Sasha7b9Work/S8-57M/readme.txt

Версия с дисплеем на stm32f479 и без мультиметра
