Sasha7b9Work/S8-57M/sources/Panel/src/Hardware/Keyboard.cpp

// (c) Aleksandr Shevchenko e-mail : Sasha7b9@tut.by
#include "defines.h"
#include "common/Command.h"
#include "Hardware/Keyboard.h"
#include "Hardware/HAL/HAL.h"
#include "Display/Text/Text.h"
#include "Hardware/Timer.h"
#include "Log.h"


#define SL0 GPIO_PIN_2
#define SL1 GPIO_PIN_13
#define SL2 GPIO_PIN_14
#define SL3 GPIO_PIN_15
#define SL4 GPIO_PIN_1
#define SL5 GPIO_PIN_2
#define SL6 GPIO_PIN_3
#define SL7 GPIO_PIN_0

#define RL0 GPIO_PIN_6
#define RL1 GPIO_PIN_5
#define RL2 GPIO_PIN_2
#define RL3 GPIO_PIN_12
#define RL4 GPIO_PIN_11
#define RL5 GPIO_PIN_10


static const Control controls[Keyboard::NUM_RL][Keyboard::NUM_SL] =
{ //          SL0/SL6                SL1/SL7                  SL2                     SL3                     SL4                     SL5              
    {Control::K_None,       Control::B_3,            Control::B_Down,        Control::K_None,        Control::B_TrigLevLess, Control::B_TrigLevMore,
     Control::B_RangeLessB, Control::B_RShiftMoreB},                                                                                            // RL0

    {Control::B_1,          Control::B_4,            Control::B_Right,       Control::B_Enter,       Control::K_Start,       Control::K_Trig,
     Control::B_RangeMoreB, Control::B_RShiftLessB},                                                                                            // RL1

    {Control::B_2,          Control::B_5,            Control::B_Up,          Control::B_Left,        Control::K_None,        Control::K_None,
     Control::K_None,       Control::K_ChannelB},                                                                                               // RL2

    {Control::K_Function,   Control::K_Service,      Control::B_RangeLessA,  Control::K_RangeMoreA,  Control::K_None,        Control::B_TShiftLess,
     Control::K_None,       Control::K_None},                                                                                                   // RL3
                                                     
    {Control::K_Measures,   Control::K_None,         Control::K_ChannelA,    Control::K_None,        Control::B_TBaseMore,   Control::B_TShiftMore,
     Control::K_None,       Control::K_None},                                                                                                   // RL4
                                                     
    {Control::K_Memory,     Control::K_Display,      Control::B_RShiftMoreA, Control::B_RShiftLessA, Control::K_Time,        Control::B_TBaseLess,
     Control::K_None,       Control::K_None}                                                                                                    // RL5
};               


static uint16 sls[Keyboard::NUM_SL]             = {SL0,   SL1,   SL2,   SL3,   SL4,   SL5,   SL6,   SL7};
static GPIO_TypeDef* slsPorts[Keyboard::NUM_SL] = {GPIOE, GPIOC, GPIOC, GPIOC, GPIOC, GPIOC, GPIOC, GPIOA};

static uint16 rls[Keyboard::NUM_RL]             = {RL0,   RL1,   RL2,   RL3,   RL4,   RL5};
static GPIO_TypeDef* rlsPorts[Keyboard::NUM_RL] = {GPIOB, GPIOB, GPIOD, GPIOC, GPIOC, GPIOC};

#define SET_SL(n)   HAL_GPIO_WritePin(slsPorts[n], sls[n], GPIO_PIN_SET)
#define SET_ALL_SL  HAL_GPIO_WritePin(GPIOA, SL7, GPIO_PIN_SET);                                    \
                    HAL_GPIO_WritePin(GPIOC, SL1 | SL2 | SL3 | SL4 | SL5 | SL6, GPIO_PIN_SET);      \
                    HAL_GPIO_WritePin(GPIOE, SL0, GPIO_PIN_SET)
#define RESET_SL(n) HAL_GPIO_WritePin(slsPorts[n], sls[n], GPIO_PIN_RESET)
#define READ_RL(n)  HAL_GPIO_ReadPin(rlsPorts[n], rls[n])

#define BUTTON_IS_PRESS(state) ((state) == 0)

// Время последнего автонажатия нопки
static uint prevRepeat = 0;
static uint prevPause = 0;


static void SendCommand(Control control, Control::Action::E action);

static uint TimeBetweenRepeats(uint time);
// При обнаружении нажатия кнопки сюда записывается время нажатия
static uint timePress[Keyboard::NUM_RL][Keyboard::NUM_SL];
// Установленное в true значение означает, что сохранять куда-либо информацию о её состоянии нельзя до отпускания (чтобы не было ложных
// срабатываний типа Long
static bool alreadyLong[Keyboard::NUM_RL][Keyboard::NUM_SL];

static bool init;



void Keyboard::Init()
{
    for (int i = 0; i < NUM_RL; ++i)
    {
        for (int j = 0; j < NUM_SL; ++j)
        {
            timePress[i][j] = 0;
        }
    }

    GPIO_InitTypeDef isGPIO;

    // порты ввода
    isGPIO.Pin = RL0 | RL1;
    isGPIO.Mode = GPIO_MODE_INPUT;
    isGPIO.Pull = GPIO_PULLUP;
    HAL_GPIO_Init(GPIOB, &isGPIO);

    isGPIO.Pin = RL3 | RL4 | RL5;
    HAL_GPIO_Init(GPIOC, &isGPIO);

    isGPIO.Pin = RL2;
    HAL_GPIO_Init(GPIOD, &isGPIO);

    // порты вывода
    isGPIO.Pin = SL7;
    isGPIO.Mode = GPIO_MODE_OUTPUT_PP;
    HAL_GPIO_Init(GPIOA, &isGPIO);

    isGPIO.Pin = GPIO_PIN_14 | GPIO_PIN_15;
    HAL_GPIO_Init(GPIOB, &isGPIO);

    isGPIO.Pin = SL1 | SL2 | SL3 | SL4 | SL5 | SL6;
    HAL_GPIO_Init(GPIOC, &isGPIO);

    isGPIO.Pin = SL0;
    HAL_GPIO_Init(GPIOE, &isGPIO);

    SET_ALL_SL;

    init = true;
}


void Keyboard::Update()
{
    if (!init)
    {
        return;
    }

    uint time = HAL_GetTick();

    for (int sl = 0; sl < NUM_SL; ++sl)
    {
        RESET_SL(sl);

        for (int rl = 0; rl < NUM_RL; ++rl)
        {
            uint state = READ_RL(rl);

            Control control = controls[rl][sl];

            if (control != Control::K_None)
            {
                if (timePress[rl][sl])                      // Если клавиша находится в нажатом положении
                {
                    Timer::PauseOnTime(1);

                    if (time - timePress[rl][sl] > 100)     // Если прошло более 100 мс с момента нажатия
                    {
                        if (!BUTTON_IS_PRESS(state))        // Если сейчас кнопка находится в отжатом состояини
                        {
                            timePress[rl][sl] = 0;
                            if (!alreadyLong[rl][sl])
                            {
                                SendCommand(controls[rl][sl], Control::Action::Release);
                            }
                            alreadyLong[rl][sl] = false;
                            prevRepeat = 0;
                        }
                        else if(control.IsRepeatable() && !alreadyLong[rl][sl])  // А здесь она нходится в нажатом положении - отрабатываем автоповтор
                        {
                            if (prevRepeat == 0)
                            {
                                prevRepeat = time;
                                prevPause = 100;
                            }
                            
                            if (prevRepeat + prevPause < time)
                            {
                                prevPause = TimeBetweenRepeats(prevPause);
                                prevRepeat = time;
                                SendCommand(controls[rl][sl], Control::Action::Repeat);
                            }
                        }
                        else if(time - timePress[rl][sl] > 500 && !alreadyLong[rl][sl])
                        {
                            SendCommand(controls[rl][sl], Control::Action::Long);
                            alreadyLong[rl][sl] = true;
                        }
                    }
                }
                else if (BUTTON_IS_PRESS(state) && !alreadyLong[rl][sl])
                {
                    timePress[rl][sl] = time;
                    SendCommand(controls[rl][sl], Control::Action::Press);
                    prevRepeat = 0;
                }
            }
        }

        SET_ALL_SL;
    }

    SET_ALL_SL;
}


static void SendCommand(Control control, Control::Action::E action)
{
    uint8 data[3] =
    {
        Command::ButtonPress,
        (uint8)(control),
        (uint8)(action)
    };

    HAL_BUS::SendToDevice(data, 3);
}   


pchar Keyboard::ControlName(Control control)
{
    static pchar names[Control::Count] =
    {
        "None",
        "Функция",
        "Измер",
        "Память",
        "Сервис",
        "Канал 1",
        "Канал 2",
        "Развертка",
        "Пуск/стоп",
        "Синхр",
        "Дисплей",
        "Range 1 больше",
        "Range 1 меньше",
        "RShift 1 больше",
        "RShift 1 меньше",
        "Range 2 больше",
        "Range 2 меньше",
        "RShift 2 больше",
        "RShift 2 меньше",
        "TBase больше",
        "TBase меньше",
        "TShift больше",
        "TShift меньше",
        "Синхр больше",
        "Синхр меньше",
        "Влево",
        "Вправо",
        "Вверх",
        "Вниз",
        "Ввод",
        "1",
        "2",
        "3",
        "4",
        "5"
    };

    return names[control];
}


bool Control::IsRepeatable() const
{
    return value == B_RShiftLessA ||
        value == B_RShiftMoreA ||
        value == B_RShiftLessB ||
        value == B_RShiftMoreB ||
        value == B_TShiftLess ||
        value == B_TShiftMore ||
        value == B_TrigLevLess ||
        value == B_TrigLevMore ||
        value == B_Left ||
        value == B_Right ||
        value == B_Down ||
        value == B_Up;
}


static uint TimeBetweenRepeats(uint prev)
{
    uint retValue = (uint)((float)prev / 1.1F);

    if (retValue < 10)
    {
        retValue = 10;
    }

    return retValue;
}
