Sasha7b9Work/S8-57M/sources/DLoader/src/FlashDrive/FlashDrive.cpp

#include "defines.h"
#include "FlashDrive/FlashDrive.h"
#include "Hardware/CPU.h"
#include "Hardware/Timer.h"
#include "Hardware/HAL/HAL.h"
#include "Hardware/HAL/HAL_PIO.h"
#include <usbh_diskio.h>
#include <ctype.h>


#define FILE_FIRMWARE "S8-57.bin"
#define FILE_CLEAR "clear.txt"


struct StructForReadDir
{
    char nameDir[_MAX_LFN + 1];
    char lfn[(_MAX_LFN + 1)];
    FILINFO fno;
    DIR dir;
};


struct StateDisk
{
    enum E
    {
        Idle,
        Start
    };
};

static HCD_HandleTypeDef handleHCD;

static USBH_HandleTypeDef handleUSBH;

// Сколько процентов файла переписано
static float percentsUpdate = 0.0F;

// Состояние флешки
static State::E state = State::Start;

static FATFS        USBDISKFatFS;
static char         USBDISKPath[4];
static StateDisk::E stateDisk;
static FIL          file;
static int          connection;
static int          active;


static bool GetNameFile(pchar fullPath, int numFile, char *nameFileOut, StructForReadDir *s);
static bool GetNextNameFile(char *nameFileOut, StructForReadDir *s);
static void USBH_UserProcess(USBH_HandleTypeDef *phost, uint8 id);
static bool Process();

// Стереть настройки
void EraseSettings();

// Записать в EEPROM файл с прошивкой с флешки
void Upgrade();


void *FDrive::GetHandleHCD()
{
    return &handleHCD;
}


void *FDrive::GetHandleUSBH()
{
    return &handleUSBH;
}


void FDrive::Init()
{
    __GPIOB_CLK_ENABLE();
    __USB_OTG_HS_CLK_ENABLE(); //-V760
    __HAL_RCC_USB_OTG_HS_CLK_ENABLE();
    __SYSCFG_CLK_ENABLE();

    HAL_PIO::Init(PIN_HCD_DM, HMode::AF_PP, HPull::No, HSpeed::High, HAlternate::AF12_OTG_HS_FS);
    HAL_PIO::Init(PIN_HCD_DP, HMode::AF_PP, HPull::No, HSpeed::High, HAlternate::AF12_OTG_HS_FS);

    HAL_NVIC_SetPriority(OTG_HS_IRQn, 5, 1);

    HAL_NVIC_EnableIRQ(OTG_HS_IRQn);

    stateDisk = StateDisk::Idle;
    connection = 0;
    active = 0;

    if(FATFS_LinkDriver(&USBH_Driver, USBDISKPath) == FR_OK) //-V2001
    {
        USBH_StatusTypeDef res = USBH_Init(&handleUSBH, USBH_UserProcess, 0);
        res = USBH_RegisterClass(&handleUSBH, USBH_MSC_CLASS);
        res = USBH_Start(&handleUSBH);
    }
}



void USBH_UserProcess(USBH_HandleTypeDef *, uint8 id)
{
    switch(id)
    {
    case HOST_USER_SELECT_CONFIGURATION:
        break;

    case HOST_USER_CLASS_ACTIVE:
        active++;
        stateDisk = StateDisk::Start;
        break;

    case HOST_USER_CLASS_SELECTED:
        break;

    case HOST_USER_CONNECTION:
        connection++;
        state = State::Mount;
        f_mount(nullptr, (TCHAR const *)"", 0);
        break;

    case HOST_USER_DISCONNECTION:
        break;

    default:
        // ничего не делаем
        break;
    }
}



void FDrive::AttemptUpdate()
{
    uint timeStart = TIME_MS;

    while(TIME_MS - timeStart < TIME_WAIT && !Process())
    {
    }

    if((connection != 0 && active == 0) ||      // Если флеша подключена, но в активное состояние почему-то не перешла
        (active != 0 && state != State::Mount)) // или перешла в активное состояние, по почему-то не запустился процесс монтирования
    {
        NVIC_SystemReset();
    }

    if(state == State::Mount)                   // Это означает, что диск удачно примонтирован //-V774
    {
        if(FileExist(FILE_CLEAR))
        {
            EraseSettings();
        }

        if(FileExist(FILE_FIRMWARE))            // Если на диске обнаружена прошивка
        {
            Upgrade();
        }
    }
    else if(state == State::WrongFlash)         // Диск не удалось примонтировать //-V774
    {
        Timer::PauseOnTime(5000);
    }

    state = State::Ok;
}



static bool Process()
{
    USBH_Process(&handleUSBH);
    if(stateDisk == StateDisk::Start)
    {
        if(f_mount(&(USBDISKFatFS), (TCHAR const *)USBDISKPath, 0) == FR_OK)
        {
            return true;
        }
        else
        {
            state = State::WrongFlash;
            return false;
        }
    }
    return false;
}



static void ToLower(char *str)
{
    while(*str)
    {
        *str = (char)(tolower(*str));
        str++;
    }
}



bool FDrive::FileExist(pchar fileName)
{
    char nameFile[255];
    char f[255];
    strcpy(f, fileName);
    ToLower(f);
    StructForReadDir strd;

    if(GetNameFile("\\", 0, nameFile, &strd))
    {
        ToLower(nameFile);
        if(strcmp(f, nameFile) == 0)
        {
            return true;
        }
        while(GetNextNameFile(nameFile, &strd))
        {
            ToLower(nameFile);
            if(strcmp(f, nameFile) == 0)
            {
                return true;
            }
        }
    }

    return false;
}



static bool GetNameFile(pchar fullPath, int numFile, char *nameFileOut, StructForReadDir *s)
{
    memcpy((uint8 *)s->nameDir, (char *)(fullPath), strlen(fullPath));
    s->nameDir[strlen(fullPath)] = '\0';

    DIR *pDir = &s->dir;
    FILINFO *pFNO = &s->fno;
    if(f_opendir(pDir, s->nameDir) == FR_OK)
    {
        int numFiles = 0;
        bool alreadyNull = false;
        while(true)
        {
            if(f_readdir(pDir, pFNO) != FR_OK)
            {
                *nameFileOut = '\0';
                f_closedir(pDir);
                return false;
            }
            if(pFNO->fname[0] == 0)
            {
                if(alreadyNull)
                {
                    *nameFileOut = '\0';
                    f_closedir(pDir);
                    return false;
                }
                alreadyNull = true;
            }
            if(numFile == numFiles && (pFNO->fattrib & AM_DIR) == 0)
            {
                strcpy(nameFileOut, pFNO->fname);
                return true;
            }
            if((pFNO->fattrib & AM_DIR) == 0 && (pFNO->fname[0] != '.'))
            {
                numFiles++;
            }
        }
    }
    return false;
}



static bool GetNextNameFile(char *nameFileOut, StructForReadDir *s)
{
    FILINFO *pFNO = &s->fno;
    bool alreadyNull = false;
    while(true)
    {
        if(f_readdir(&s->dir, &s->fno) != FR_OK)
        {
            *nameFileOut = '\0';
            f_closedir(&s->dir);
            return false;
        }
        if(s->fno.fname[0] == 0)
        {
            if(alreadyNull)
            {
                *nameFileOut = '\0';
                f_closedir(&s->dir);
                return false;
            }
            alreadyNull = true;
        }
        else
        {
            if((pFNO->fattrib & AM_DIR) == 0 && pFNO->fname[0] != '.')
            {
                strcpy(nameFileOut, pFNO->fname);
                return true;
            }
        }
    }
}


int FDrive::OpenFileForRead(pchar fileName)
{
    if(f_open(&file, fileName, FA_READ) == FR_OK)
    {
        return (int)f_size(&file);
    }
    return -1;
}


int FDrive::ReadFromFile(int numBytes, uint8 *buffer)
{
    uint readed = 0;
    if(f_read(&file, buffer, (UINT)numBytes, &readed) == FR_OK)
    {
        return (int)(readed);
    }
    return -1;
}


void FDrive::CloseOpenedFile()
{
    f_close(&file);
}


void FDrive::LL_::InitHCD(void *host)
{
    USBH_HandleTypeDef *phost = (USBH_HandleTypeDef *)host;

    handleHCD.Instance = USB_OTG_HS;
    handleHCD.Init.speed = HCD_SPEED_HIGH;
    handleHCD.Init.Host_channels = 12;
    handleHCD.Init.dma_enable = 0;
    handleHCD.Init.low_power_enable = 0;
    handleHCD.Init.phy_itface = HCD_PHY_EMBEDDED;
    handleHCD.Init.Sof_enable = 0;
    handleHCD.Init.vbus_sensing_enable = 0;
    handleHCD.Init.use_external_vbus = 0;

    handleHCD.pData = phost;
    phost->pData = &handleHCD;

    HAL_HCD_Init(&handleHCD);

    USBH_LL_SetTimer(phost, HAL_HCD_GetCurrentFrame(&handleHCD));
}


void FDrive::LL_::SetToggle(uint8 pipe, uint8 toggle)
{
    if(handleHCD.hc[pipe].ep_is_in)
    {
        handleHCD.hc[pipe].toggle_in = toggle;
    }
    else
    {
        handleHCD.hc[pipe].toggle_out = toggle;
    }
}


uint8 FDrive::LL_::GetToggle(uint8 pipe)
{
    uint8 toggle = 0;

    if(handleHCD.hc[pipe].ep_is_in)
    {
        toggle = handleHCD.hc[pipe].toggle_in;
    }
    else
    {
        toggle = handleHCD.hc[pipe].toggle_out;
    }
    return toggle;
}


void EraseSettings()
{
    HAL_EEPROM::EraseSector(0x080C0000);
}

void Upgrade()
{
#define sizeSector (1 * 1024)

    uint8 buffer[sizeSector];

    CPU::FLASH_::Prepare();

    int size = FDrive::OpenFileForRead(FILE_FIRMWARE);
    int fullSize = size;
    uint address = CPU::FLASH_::ADDR_SECTOR_PROGRAM_0;

    while(size)
    {
        int readedBytes = FDrive::ReadFromFile(sizeSector, buffer);
        CPU::FLASH_::WriteData(address, buffer, readedBytes);
        size -= readedBytes;
        address += (uint)(readedBytes);

        percentsUpdate = 1.0F - (float)size / (float)fullSize;
    }

    FDrive::CloseOpenedFile();
}


float FDrive::PercentsUpdated()
{
    return percentsUpdate;
}


State::E FDrive::State()
{
    return state;
}
