Sasha7b9Work/S8-57M/sources/fonts/MatrixFont/bin/settings.ini

[Last Parameters]
WindowPosition=1
WindowMainTop=315
WindowMainLeft=540
WindowMainWidth=600
WindowMainHeight=420
WindowMainState=2
Splitter=313
Grid=1
Rollover=1
OnTop=0
Preview=0
CodeFontSize=17

[Last Opened Files]
File_0=D:\Projects\S8-57M\sources\fonts\FontDiag.RHF
File_1=D:\Projects\S8-57M\sources\fonts\FontSmall.RHF
File_2=D:\Projects\S8-57M\sources\fonts\FontUGO.RHF
File_3=D:\Projects\S8-57M\sources\fonts\FontDIAG.RHF
File_4=D:\Projects\S8-57M\sources\fonts\Font64.RHF
File_5=
File_6=
File_7=
File_8=
File_9=
acViewTBCommon_Checked=1
acViewTBEffectsChar_Checked=1
acViewTBEffectsFont_Checked=1
acViewTBEditChar_Checked=1
acViewTBEditFont_Checked=1

[TApplication.fmMain]
acViewTBCommon_Checked=1
acViewTBEffectsChar_Checked=1
acViewTBEffectsFont_Checked=1
acViewTBEditChar_Checked=1
acViewTBEditFont_Checked=1

[TApplication.fmSettings]
cbCharName_Checked=1
cbCharNameFont_Text=Consolas
cbChessGrid_Checked=0
cbCodeHex_Checked=0
cbCodeName_Checked=1
cbCodeNameFont_Text=Consolas
cbLanguage_ItemIndex=0
cbMagnetPreview_Checked=1
cbNaviInvert_Checked=1
cbNaviScroll_Checked=0
cbNaviTransparent_Checked=1
cbtnActive_ButtonColor=0
cbtnBackground_Color=536870912
cbtnGrid_ButtonColor=12303291
cbtnImportA_ButtonColor=16777215
cbtnImportBG_ButtonColor=32768
cbtnNaviA_ButtonColor=0
cbtnNaviBG_ButtonColor=16777215
cbtnPreviewA_ButtonColor=16777215
cbtnPreviewBG_ButtonColor=10485760
edAuthor_Text=DESKTOP-AD6U45M / Sasha
edFontName_Text=New
seCharNameFontSize_Value=23
seCodeNameFontSize_Value=12
seGridThickness_Value=1
seNaviHeight_Value=30
cbEncoding_ItemIndex=0

[TApplication.fmPreview]
seDelta_Value=5
seSpace_Value=4
rbMono_Checked=0
rbProp_Checked=1

[TApplication.fmImport]
cbOptimize_Checked=1
cbSnapLeft_Checked=1

[TApplication.fmImport.mmExample_Lines]
Count=2
Item0=AaBbCcXxYyZz АаБбВвЭэЮюЯя
Item1=Example Пример 12345
