Sasha7b9Work/S8-57M/sources/Device/src/Display/Display.h

// (c) Aleksandr Shevchenko e-mail : Sasha7b9@tut.by
#pragma once
#include "Keyboard/Keyboard.h"



#define DISPLAY_SHOW_WARNING(warn)  Display::ShowWarning(warn)

#define MOSI_HEIGHT         9
#define MOI_HEIGHT_TITLE    19
#define MOI_WIDTH_D_IP      34      /* Увеличение ширины открытого ip-адреса в случае наличия порта */
#define GRID_DELTA          20      /* Количество точек в клетке */

#define TIME_MESSAGES               5


#define DISPLAY_ORIENTATION         (set.dbg_Orientation)
#define DISPLAY_ORIENTATION_IS_NORMAL (DISPLAY_ORIENTATION == Display::Orientation::Normal)

#define SET_NUM_BYTES_ON_DISPLAY    (SET_PEAKDET_EN ? 281 * 2 : 281)

#define SHIFT_IN_MEMORY_IN_POINTS   Display::ShiftInMemoryInPoints()


struct DrawMode
{
    enum E
    {
        Auto,
        Hand
    } value;
};

namespace Display
{
    const int HEIGHT = 480;
    const int WIDTH = 640;

    void Init();

    // Здесь происходит вся отрисовка
    void Update();

    // Возвращаемое значение true означает, что дисплей находится в состоянии отрисовки
    bool InProcess();

    // Устанавливает функцию, которая выполится после отрисовки кадра однократно
    void SetFuncAfterUpadteOnce(pFuncVV func);

    void ShowWarning(pchar warnRU);

    // @brief Установить функцию и режим отрисовки экрана.
    // @details Возможны три варианта.
    // 1. DrawMode_Hand - в этом случае будет вызываться функция func(), определяемая пользователем, с частотой 25 раз в секунду.
    // Используется в случаях, когда не выполняется главный цикл.
    // 2. DrawMode::Auto и func == 0 - в этом случае будет выполняться функция Update() в главном цикле.
    // 3. DrawMode::Auto и func != 0 - в этом случае будет выполняться функция func(), определяемая пользователем, но в теле
    // главного цикла, будучи вызываемой из Update() вместо Update().
    void SetDrawMode(DrawMode::E mode, pFuncVV func = nullptr);

    // Возвращает время, через которое меню автоматически скрывается, если не было больше нажатий
    int TimeMenuAutoHide();

    // Если экран разделён на две части и основной сигнал выводится сверху - например, в режиме вывода спектра
    bool IsSeparate();

    void LoadBrightness();

    namespace AdditionalFunctionDraw
    {
        // Устанавливает дополнительную функцию, которая будет отрисовываться каждый раз после обновления экрана
        // timeRemove - время, по истечении которого дополнительная функция отрисовки будет удалена. Если его не указывать, фукнция удаляться самостоятельно не будет
        void Set(pFuncVI func, uint timeRemove = 0);

        // Удаляет дополнительую функцию отрисовки, установленную вызовом функции SetAddDrawFunction()
        void Remove();
    }


    struct Message
    {
        // Выводит на экран сообщение. Для удаления нунжно вызвать функцию Stop()
        static void Show(pchar text, bool eraseBackground);

        // Выводит на экран сообщение и ожидает нажатия кнопки. По нажатии сообщение исчезает с экрана
        static void ShowAndWaitKey(pchar text, bool eraseBackground);

        static void Hide();

    private:
        static void Func();

        static bool waitKey;

        static volatile bool running;
    };

    struct Breaker
    {
        static void PowerOff();

        static bool PowerOn();      // Возвращает true, если включение действительно было (вызов при выключенном был)

    private:
        static bool powerOn;        // Установленное в false значение означает, что дисплей находится в выключенном состоянии (яркость равна нулю)
    };
};
