Sasha7b9Work/S8-57M/sources/Device/src/Hardware/HAL/HAL_FSMC_stm.cpp

// (c) Aleksandr Shevchenko e-mail : Sasha7b9@tut.by
#include "defines.h"
#include "FPGA/TypesFPGA.h"
#include "Hardware/Timer.h"
#include "Hardware/HAL/HAL.h"
#include "Settings/SettingsNRST.h"
#include "Utils/Debug.h"
#include "Utils/Math.h"
#include <stm32f4xx_hal.h>


#define ADDR_ALTERA1    ((uint8 *)NOR_MEMORY_ADRESS1)
//#define ADDR_ALTERA2    ((uint8 *)NOR_MEMORY_ADRESS2)
//#define ADDR_ALTERA3    ((uint8 *)NOR_MEMORY_ADRESS3)
//#define ADDR_DISPLAY    ((uint8 *)NOR_MEMORY_ADRESS4)


namespace HAL_BUS
{
    static GPIO_InitTypeDef is =
    {
        GPIO_PIN_0,
        GPIO_MODE_AF_PP,
        GPIO_PULLUP,
        GPIO_SPEED_FREQ_VERY_HIGH,
        GPIO_AF12_FMC
    };

    Mode::E mode = Mode::FSMC;

    // Настроить FSMC для работы с внешней RAM
    static void InitRAM();

    // Инициализация пинов панели, которые не изменяют свой режим во время всей работы программы
    void InitPanel();

    namespace FPGA
    {
        // Первый адрес чтения данных
        static uint8 *addrData0 = nullptr;
        // Второй адрес чтения данных
        static uint8 *addrData1 = nullptr;
    }
}


void HAL_BUS::Init()
{
    __HAL_RCC_FMC_CLK_ENABLE();
    __HAL_RCC_GPIOF_CLK_ENABLE();

    //           D2           D3           D0            D1
    is.Pin = GPIO_PIN_0 | GPIO_PIN_1 | GPIO_PIN_14 | GPIO_PIN_15;
    HAL_GPIO_Init(GPIOD, &is);

    //           D4           D5           D6           D7
    is.Pin = GPIO_PIN_7 | GPIO_PIN_8 | GPIO_PIN_9 | GPIO_PIN_10;
    HAL_GPIO_Init(GPIOE, &is);

    //           A0           A1           A2           A3           A4           A5           A6            A7            A8            A9
    is.Pin = GPIO_PIN_0 | GPIO_PIN_1 | GPIO_PIN_2 | GPIO_PIN_3 | GPIO_PIN_4 | GPIO_PIN_5 | GPIO_PIN_12 | GPIO_PIN_13 | GPIO_PIN_14 | GPIO_PIN_15;
    HAL_GPIO_Init(GPIOF, &is);

    //           A10          A11         A12           A13          A14         A15           NE3
    is.Pin = GPIO_PIN_0 | GPIO_PIN_1 | GPIO_PIN_2 | GPIO_PIN_3 | GPIO_PIN_4 | GPIO_PIN_5 | GPIO_PIN_10;
    HAL_GPIO_Init(GPIOG, &is);

    //           A16          A17            A18
    is.Pin = GPIO_PIN_11 | GPIO_PIN_12 | GPIO_PIN_13;
    HAL_GPIO_Init(GPIOD, &is);

    static const GPIO_InitTypeDef isGPIO =
    {   //    NOE          NWE          NE1
        GPIO_PIN_4 | GPIO_PIN_5 | GPIO_PIN_7,
        GPIO_MODE_AF_PP,
        GPIO_PULLUP,
        GPIO_SPEED_FREQ_VERY_HIGH,
        GPIO_AF12_FMC
    };

    // \todo Здесь не довеедно - не хотит, почему-то

    HAL_GPIO_Init(GPIOD, (GPIO_InitTypeDef *)&isGPIO);


    static SRAM_HandleTypeDef gSramHandle =
    {
        FMC_NORSRAM_DEVICE,
        FMC_NORSRAM_EXTENDED_DEVICE,
        {
            FMC_NORSRAM_BANK1,                 // Init.NSBank
            FMC_DATA_ADDRESS_MUX_DISABLE,      // Init.DataAddressMux
            FMC_MEMORY_TYPE_NOR,               // Init.MemoryType
            FMC_NORSRAM_MEM_BUS_WIDTH_8,       // Init.MemoryDataWidth
            FMC_BURST_ACCESS_MODE_DISABLE,     // Init.BurstAccessMode
            FMC_WAIT_SIGNAL_POLARITY_LOW,      // Init.WaitSignalPolarity
            FMC_WRAP_MODE_DISABLE,             // Init.WrapMode
            FMC_WAIT_TIMING_BEFORE_WS,         // Init.WaitSignalActive
            FMC_WRITE_OPERATION_ENABLE,        // Init.WriteOperation
            FMC_WAIT_SIGNAL_DISABLE,           // Init.WaitSignal
            FMC_EXTENDED_MODE_DISABLE,         // Init.ExtendedMode
            FMC_ASYNCHRONOUS_WAIT_DISABLE,     // Init.AsynchronousWait
            FMC_WRITE_BURST_DISABLE            // Init.WriteBurst
        }
    };

    static const FMC_NORSRAM_TimingTypeDef sramTiming =
    {
        0,                 // FSMC_AddressSetupTime
        0,                 // FSMC_AddressHoldTime
        6,                 // FSMC_DataSetupTime   При значении 9 32кБ записываются в RAM за 1000мкс. Уменьшение
                           // на одну единцу уменьшает этот параметр на 90 мкс. Если 3 - 32кБ запишутся за 460 мкс.
        0,                 // FSMC_BusTurnAroundDuration
        0,                 // FSMC_CLKDivision
        0,                 // FSMC_DataLatency
        FMC_ACCESS_MODE_C  // FSMC_AccessMode
    };

    SRAM_HandleTypeDef *hsram = &gSramHandle;
    FMC_NORSRAM_TimingTypeDef *Timing = (FMC_NORSRAM_TimingTypeDef *)&sramTiming;

    FMC_NORSRAM_Init(hsram->Instance, &(hsram->Init));

    FMC_NORSRAM_Timing_Init(hsram->Instance, Timing, hsram->Init.NSBank);

    hsram->Extended->BWTR[hsram->Init.NSBank] = 0x0FFFFFFFU;

    __FMC_NORSRAM_ENABLE(hsram->Instance, hsram->Init.NSBank);

    InitPanel();

    InitRAM();
}


void HAL_BUS::InitRAM()
{
    __HAL_RCC_GPIOD_CLK_ENABLE();
    __HAL_RCC_GPIOG_CLK_ENABLE();

    //           A16           A17           A18 
    is.Pin = GPIO_PIN_11 | GPIO_PIN_12 | GPIO_PIN_13;
    HAL_GPIO_Init(GPIOD, &is);

    //           A10          A11         A12           A13          A14         A15           NE3
    is.Pin =  GPIO_PIN_0 | GPIO_PIN_1 | GPIO_PIN_2 | GPIO_PIN_3 | GPIO_PIN_4 | GPIO_PIN_5 | GPIO_PIN_10;
    HAL_GPIO_Init(GPIOG, &is);

    //           A6            A7          A8            A9
    is.Pin = GPIO_PIN_12 | GPIO_PIN_13 | GPIO_PIN_14 | GPIO_PIN_15;
    HAL_GPIO_Init(GPIOF, &is);

    static SRAM_HandleTypeDef gSramHandle =
    {
        FMC_NORSRAM_DEVICE,
        FMC_NORSRAM_EXTENDED_DEVICE,
        {
            FMC_NORSRAM_BANK3,                 // Init.NSBank
            FMC_DATA_ADDRESS_MUX_DISABLE,      // Init.DataAddressMux
            FMC_MEMORY_TYPE_NOR,               // Init.MemoryType
            FMC_NORSRAM_MEM_BUS_WIDTH_8,       // Init.MemoryDataWidth
            FMC_BURST_ACCESS_MODE_DISABLE,     // Init.BurstAccessMode
            FMC_WAIT_SIGNAL_POLARITY_LOW,      // Init.WaitSignalPolarity
            FMC_WRAP_MODE_DISABLE,             // Init.WrapMode
            FMC_WAIT_TIMING_BEFORE_WS,         // Init.WaitSignalActive
            FMC_WRITE_OPERATION_ENABLE,        // Init.WriteOperation
            FMC_WAIT_SIGNAL_DISABLE,           // Init.WaitSignal
            FMC_EXTENDED_MODE_DISABLE,         // Init.ExtendedMode
            FMC_ASYNCHRONOUS_WAIT_DISABLE,     // Init.AsynchronousWait
            FMC_WRITE_BURST_DISABLE            // Init.WriteBurst
        }
    };

    static const FMC_NORSRAM_TimingTypeDef sramTiming =
    {
        0,                 // FSMC_AddressSetupTime
        0,                 // FSMC_AddressHoldTime
        6,                 // FSMC_DataSetupTime   При значении 9 32кБ записываются в RAM за 1000мкс. Уменьшение
                           // на одну единцу уменьшает этот параметр на 90 мкс. Если 3 - 32кБ запишутся за 460 мкс.
        0,                 // FSMC_BusTurnAroundDuration
        0,                 // FSMC_CLKDivision
        0,                 // FSMC_DataLatency
        FMC_ACCESS_MODE_C  // FSMC_AccessMode
    };

    FMC_NORSRAM_TimingTypeDef *timing = (FMC_NORSRAM_TimingTypeDef *)&sramTiming;

    HAL_SRAM_Init(&gSramHandle, timing, timing);
}


void HAL_BUS::ConfigureToFSMC()
{
    mode = Mode::FSMC;

    //           NOE          NWE          NE1
    is.Pin = GPIO_PIN_4 | GPIO_PIN_5 | GPIO_PIN_7;   
    HAL_GPIO_Init(GPIOD, &is); //-V525

    //           D2           D3           D0            D1
    is.Pin = GPIO_PIN_0 | GPIO_PIN_1 | GPIO_PIN_14 | GPIO_PIN_15;
    HAL_GPIO_Init(GPIOD, &is);

    //           D4           D5           D6           D7
    is.Pin = GPIO_PIN_7 | GPIO_PIN_8 | GPIO_PIN_9 | GPIO_PIN_10;
    HAL_GPIO_Init(GPIOE, &is);
}


void HAL_BUS::FPGA::Write16(uint8 *address, uint16 value)
{
    HAL_BUS_CONFIGURE_TO_FSMC();

    PAUSE_ON_TICKS(100);    // \todo Без этой строки замедлен вывод при включённой оптимизации и TBase >= 0.5мс

    *address = (uint8)(value);
    *(address + 1) = (uint8)(value >> 8);


}


void HAL_BUS::FPGA::Write8(uint8 *address, uint8 value)
{
    HAL_BUS_CONFIGURE_TO_FSMC();

    *address = value;
}


uint8 HAL_BUS::FPGA::Read(const uint8 *address)
{
    HAL_BUS_CONFIGURE_TO_FSMC();

    return *address;
}


void HAL_BUS::FPGA::SetAddrData(uint8 *address0, uint8 *address1)
{
    addrData0 = address0;
    addrData1 = address1;

    HAL_BUS_CONFIGURE_TO_FSMC();
}


uint8 HAL_BUS::FPGA::ReadA0()
{
    int delta = VALUE::AVE - (int)(*addrData0);

    int result = (int)(VALUE::AVE - (int)(delta * GetStretch(addrData0)));

    if(result < VALUE::MIN)
    {
        return VALUE::MIN;
    }
    else if(result > VALUE::MAX)
    {
        return VALUE::MAX;
    }

    return (uint8)(result);
}


uint8 HAL_BUS::FPGA::ReadA1()
{
    int delta = VALUE::AVE - (int)(*addrData1);

    int result = (uint8)(VALUE::AVE - (int)(delta * GetStretch(addrData1)));

    if(result < VALUE::MIN)
    {
        return VALUE::MIN;
    }
    else if(result > VALUE::MAX)
    {
        return VALUE::MAX;
    }

    return (uint8)(result);
}


float HAL_BUS::FPGA::GetStretch(const uint8 *address)
{
    static const float *stretchs[4] =
    {
        &NRST_EX_STRETCH(ChA),
        &NRST_EX_STRETCH(ChA),
        &NRST_EX_STRETCH(ChB),
        &NRST_EX_STRETCH(ChB)
    };

    int delta = address - RD::DATA_A;

    return *stretchs[delta];
}
