Sasha7b9Work/S8-57M/sources/Device/src/FlashDrive/FileManager.cpp

// (c) Aleksandr Shevchenko e-mail : Sasha7b9@tut.by
#include "defines.h"
#include "common/Display/Font/Font.h"
#include "Display/Grid.h"
#include "Display/Painter.h"
#include "Display/Primitives.h"
#include "FlashDrive/FileManager.h"
#include "FlashDrive/FlashDrive.h"
#include "Hardware/Beeper.h"
#include "Hardware/HAL/HAL.h"
#include "Menu/Menu.h"
#include "Menu/Pages/Include/PageMemory.h"
#include "Osci/DeviceSettings.h"
#include "Utils/Math.h"
#include "Utils/Values.h"
#include "Settings/Settings.h"
#include <cstring>


#define FM_CURSOR_IN_DIRS       (bf.cursorsInDirs)

ModeRedrawFM::E ModeRedrawFM::modeRedraw = ModeRedrawFM::Full;


namespace FileManager
{
    static const int RECS_ON_PAGE = 23;
    static const int WIDTH_COL    = 135;

    static char currentDir[255] = "\\";
    static int numFirstDir = 0;         // Номер первого выведенного каталога в левой панели. Всего может быть выведено RECS_ON_PAGE каталогов
    static int numCurDir = 0;           // Номер подсвеченного каталога
    static int numFirstFile = 0;        // Номер первого выведенного файла в правой панели. Всего может быть выведено RECS_ON_PAGE файлов.
    static int numCurFile = 0;          // Номер подсвеченного файла
    static int numDirs = 0;
    static int numFiles = 0;

    static struct BitFieldFileManager
    {
        uint  cursorsInDirs : 1;
        uint  notUsed : 31;
    } bf = { 1, 0 };

    static void DrawDirs(int x, int y);
    static void DrawFiles(int x, int y);
    static void DrawNameCurrentDir(int left, int top);
    static void IncCurrentDir();
    static void DecCurrentDir();
    static void IncCurrentFile();
    static void DecCurrentFile();

    static void DrawLongString(int x, int y, pchar string, bool hightlight);
    static void DrawHat(int x, int y, pchar string, int num1, int num2);
}


void FileManager::Init()
{
    std::strcpy(currentDir, "\\");
    numFirstDir = 0;
    numFirstFile = 0;
    numCurDir = 0;
    numCurFile = 0;
}


void FileManager::DrawLongString(int x, int y, pchar string, bool hightlight)
{
    int length = Font::GetLengthText(string);

    Color color = Color::FILL;
    if (hightlight)
    {
        Region(WIDTH_COL + 9, 8).Fill(x - 1, y, color);
        color = Color::BACK;
    }

    if (length <= WIDTH_COL)
    {
        String(string).Draw(x, y, color);
    }
    else
    {
        color.SetAsCurrent();

		Text(string).DrawWithLimitation(x, y, x, y, WIDTH_COL, 10);

        String("...").Draw(x + WIDTH_COL + 3, y);
    }
}


void FileManager::DrawHat(int x, int y, pchar string, int num1, int num2)
{
    Region(WIDTH_COL + 9, RECS_ON_PAGE * 9 + 11).Fill(x - 1, y, Color::BACK);
    String(string, num1, num2).Draw(x + 60, y, Color::FILL);

	HLine(138).Draw(x + 2, y + 10);
}


void FileManager::DrawDirs(int x, int y)
{
    FDrive::GetNumDirsAndFiles(currentDir, &numDirs, &numFiles);
    DrawHat(x, y, "Каталог : %d/%d", numCurDir + ((numDirs == 0) ? 0 : 1), numDirs);
    char nameDir[255];
    StructForReadDir sfrd;
    y += 12;
    if (FDrive::GetNameDir(currentDir, numFirstDir, nameDir, &sfrd))
    {
        int  drawingDirs = 0;
        DrawLongString(x, y, nameDir, (FM_CURSOR_IN_DIRS != 0) && ( numFirstDir == numCurDir));
        while (drawingDirs < (RECS_ON_PAGE - 1) && FDrive::GetNextNameDir(nameDir, &sfrd))
        {
            drawingDirs++;
            DrawLongString(x, y + drawingDirs * 9, nameDir, (FM_CURSOR_IN_DIRS != 0) && ( numFirstDir + drawingDirs == numCurDir));
        }
    }
}


void FileManager::DrawFiles(int x, int y)
{
    DrawHat(x, y, "Файл : %d/%d", numCurFile + ((numFiles == 0) ? 0 : 1), numFiles);
    char nameFile[255];
    StructForReadDir sfrd;
    y += 12;
    if (FDrive::GetNameFile(currentDir, numFirstFile, nameFile, &sfrd))
    {
        int drawingFiles = 0;
        DrawLongString(x, y, nameFile, (FM_CURSOR_IN_DIRS == 0) && (numFirstFile == numCurFile));
        while (drawingFiles < (RECS_ON_PAGE - 1) && FDrive::GetNextNameFile(nameFile, &sfrd))
        {
            drawingFiles++;
            DrawLongString(x, y + drawingFiles * 9, nameFile, (FM_CURSOR_IN_DIRS == 0) && (numFirstFile + drawingFiles == numCurFile));
        }
    }
}


void FileManager::DrawNameCurrentDir(int left, int top)
{
    Color::FILL.SetAsCurrent();
    int length = Font::GetLengthText(currentDir);
    if (length < 277)
    {
        String(currentDir).Draw(left + 1, top + 1);
    }
    else
    {
        char *pointer = currentDir + 2;
        while (length > 277)
        {
            while (*pointer != '\\' && pointer < currentDir + 255)
            {
                pointer++;
            }
            if (pointer >= currentDir + 255)
            {
                return;
            }
            length = Font::GetLengthText(++pointer);
        }
        String(pointer).Draw(left + 1, top + 1);
    }
}


void FileManager::Draw()
{
    if (ModeRedrawFM::Is(ModeRedrawFM::None))
    {
        return;
    }

    int left = 1;
    int top = 1;
    int width = 297;
    int left2col = width / 2;

    for (int field = 0; field < 5; field++)
    {
        if (ModeRedrawFM::Is(ModeRedrawFM::Full))
        {
            Painter::BeginScene(field, Color::BACK);
            Menu::Draw(4);
            Rectangle(width, 239).Draw(0, 0, Color::FILL);
            Region(Grid::Width() - 2, Grid::Height() - 2).Fill(left, top, Color::BACK);
            FDrive::GetNumDirsAndFiles(currentDir, &numDirs, &numFiles);
            DrawNameCurrentDir(left, top + 2);

            VLine(223 - top).Draw(left2col, top + 16, Color::FILL);
            HLine(width).Draw(0, top + 15);
        }

        if (!ModeRedrawFM::Is(ModeRedrawFM::Files))
        {
            DrawDirs(left + 2, top + 18);
        }

        if (!ModeRedrawFM::Is(ModeRedrawFM::Folders))
        {
            DrawFiles(left2col + 3, top + 18);
        }

        Painter::EndScene();
    }

    ModeRedrawFM::Set(ModeRedrawFM::None);
}

void FileManager::Press_LevelDown()
{
    ModeRedrawFM::Set(ModeRedrawFM::Full);

    if (FM_CURSOR_IN_DIRS == 0)
    {
        return;
    }
    char nameDir[100];
    StructForReadDir sfrd;
    if (FDrive::GetNameDir(currentDir, numCurDir, nameDir, &sfrd))
    {
        if (std::strlen(currentDir) + std::strlen(nameDir) < 250)
        {
            FDrive::CloseCurrentDir(&sfrd);
            std::strcat(currentDir, "\\");
            std::strcat(currentDir, nameDir);
            numFirstDir = 0;
            numFirstFile = 0;
            numCurDir = 0;
            numCurFile = 0;
        }

    }
    FDrive::CloseCurrentDir(&sfrd);
}


void FileManager::Press_LevelUp()
{
    ModeRedrawFM::Set(ModeRedrawFM::Full);

    if (std::strlen(currentDir) == 1)
    {
        return;
    }
    char *pointer = currentDir + std::strlen(currentDir);
    while (*pointer != '\\')
    {
        pointer--;
    }
    *pointer = '\0';
    numFirstDir = 0;
    numFirstFile = 0;
    numCurDir = 0;
    numCurFile = 0;
    FM_CURSOR_IN_DIRS = 1;
}


void FileManager::IncCurrentDir()
{
    if (numDirs > 1)
    {
        numCurDir++;
        if (numCurDir > numDirs - 1)
        {
            numCurDir = 0;
            numFirstDir = 0;
        }
        if (numCurDir - numFirstDir > RECS_ON_PAGE - 1)
        {
            numFirstDir++;
        }
    }
}


void FileManager::DecCurrentDir()
{
    if (numDirs > 1)
    {
        numCurDir--;

        if (numCurDir < 0)
        {
            numCurDir = numDirs - 1;
            numFirstDir = numDirs - RECS_ON_PAGE;
            LIMITATION(numFirstDir, 0, numCurDir);
        }

        if (numCurDir < numFirstDir)
        {
            numFirstDir = numCurDir;
        }
    }
}


void FileManager::IncCurrentFile()
{
    if (numFiles > 1)
    {
        numCurFile++;
        if (numCurFile > numFiles - 1)
        {
            numCurFile = 0;
            numFirstFile = 0;
        }
        if (numCurFile - numFirstFile > RECS_ON_PAGE - 1)
        {
            numFirstFile++;
        }
    }
}


void FileManager::DecCurrentFile()
{
    if (numFiles > 1)
    {
        numCurFile--;

        if (numCurFile < 0)
        {
            numCurFile = numFiles - 1;
            numFirstFile = numFiles - RECS_ON_PAGE;;
            LIMITATION(numFirstFile, 0, numCurFile);
        }

        if (numCurFile < numFirstFile)
        {
            numFirstFile = numCurFile;
        }
    }
}


bool FileManager::HandlerKey(const KeyEvent &event)
{
    if (event.IsRelease() && event.IsArrow())
    {
        int delta = (event.IsArrowUp() || event.IsArrowRight()) ? 1 : -1;

        Beeper::RegulatorSwitchRotate();
        if (FM_CURSOR_IN_DIRS)
        {
            delta > 0 ? DecCurrentDir() : IncCurrentDir();

            ModeRedrawFM::Set(ModeRedrawFM::Folders);
        }
        else
        {
            delta > 0 ? DecCurrentFile() : IncCurrentFile();

            ModeRedrawFM::Set(ModeRedrawFM::Files);
        }

        return true;
    }

    return false;
}


bool FileManager::GetNameForNewFile(char name[255])
{
    static int number = 0;

    std::strcpy(name, currentDir);
    std::strcat(name, "\\");

    int size = (int)(std::strlen(S_MEM_FILE_NAME));
    if (size == 0)
    {
        return false;
    }

    if (S_MEM_FILE_NAMING_MODE_IS_MANUALLY)
    {
        LIMITATION(size, 1, 95);
        std::strcat(name, S_MEM_FILE_NAME);
        std::strcat(name, ".");
        std::strcat(name, S_MEM_MODE_SAVE_SIGNAL_IS_BMP ? "bmp" : "txt");
        return true;
    }
    else
    {
        PackedTime time = HAL_RTC::GetPackedTime();
                           //  1          2           3         4           5             6
        uint values[] = {0U, time.year, time.month, time.day, time.hours, time.minutes, time.seconds};

        char *ch = S_MEM_FILE_NAME_MASK;
        char *wr = name;

        while (*wr != '\0')
        {
            wr++;
        }

        while (*ch)
        {
            if (*ch >= 0x30)
            {
                *wr = *ch;
                wr++;
            }
            else
            {
                if (*ch == 0x07)
                {
                    number++;
                    char *strNumber = Integer(number).ToString(false, *(ch + 1)).c_str();
                    std::strcpy(wr, strNumber);
                    wr += std::strlen(strNumber);
                    ch++;
                }
                else
                {
                    if (*ch >= 0x01 && *ch <= 0x06)
                    {
                        char *strValue = Integer((int)(values[*ch])).ToString(false, 2).c_str();
                        std::strcpy(wr, strValue);
                        wr += std::strlen(strValue);
                    }
                }
            }
            ch++;
        }

        *wr = '.';
        *(wr + 1) = '\0';

        std::strcat(name, S_MEM_MODE_SAVE_SIGNAL_IS_BMP ? "bmp" : "txt");

        return true;
    }
}


void FileManager::Press_Tab()
{
    ModeRedrawFM::Set(ModeRedrawFM::Folders);

    if (FM_CURSOR_IN_DIRS)
    {
        if (numFiles != 0)
        {
            FM_CURSOR_IN_DIRS = 0;
        }
    }
    else
    {
        if (numDirs != 0)
        {
            FM_CURSOR_IN_DIRS = 1;
        }
    }
}


void ModeRedrawFM::Set(ModeRedrawFM::E mode)
{
    modeRedraw = mode;
}


bool ModeRedrawFM::Is(ModeRedrawFM::E mode)
{
    return (modeRedraw == mode);
}
