Sasha7b9Work/S8-57M/sources/Device/src/Hardware/Memory/Sector.cpp

// (c) Aleksandr Shevchenko e-mail : Sasha7b9@tut.by
#include "defines.h"
#include "Hardware/HAL/HAL.h"
#include "Hardware/Memory/Sector.h"
#include "Osci/DeviceSettings.h"


const DataSettings *PacketROM::UnPack() const
{
    if (!IsValid() || !IsData())
    {
        return nullptr;
    }

    return (DataSettings *)((const DataSettings *)((const uint8 *)this + sizeof(PacketROM)));
}


PacketROM *PacketROM::Next() const
{
    if (IsFree())
    {
        return nullptr;
    }

    return (PacketROM *)((uint8 *)((PacketROM *)this) + size); //-V650
}


int PacketROM::Size() const
{
    if (IsFree())
    {
        return (int)((Sector::Number(Address())) - Address());
    }

    return size;
}


bool PacketROM::WriteToSector(const Sector *sector) const
{
    if(UnPack() == nullptr)
    {
        return false;
    }

    const PacketROM *dest = sector->FirstPacket();

    while (dest && !dest->IsFree())
    {
        dest = dest->Next();
    }

    uint addressWrite = (uint)dest;       // По этому адресу будет производиться запись пакета

    uint lastAddress = addressWrite + size;                 // А это последний адрес записи

    if (lastAddress > sector->End())
    {
        return false;
    }

    DataSettings ds = *UnPack(); //-V522

    ds.ch_a = nullptr;
    ds.ch_b = nullptr;

    if (ds.en_a)
    {
        ds.ch_a = (uint8 *)addressWrite + sizeof(PacketROM) + sizeof(DataSettings);
    }
    if (ds.en_b)
    {
        ds.ch_b = (uint8 *)addressWrite + sizeof(PacketROM) + sizeof(DataSettings);
        if (ds.en_a)
        {
            ds.ch_b += ds.BytesInChannel();
        }
    }

    HAL_ROM::WriteBufferBytes(addressWrite, this, sizeof(PacketROM));

    addressWrite += sizeof(PacketROM);

    HAL_ROM::WriteBufferBytes(addressWrite, &ds, sizeof(DataSettings));

    addressWrite += sizeof(DataSettings);

    if (ds.en_a)
    {
        HAL_ROM::WriteBufferBytes(addressWrite, UnPack()->ch_a, ds.BytesInChannel());
        addressWrite += ds.BytesInChannel();
    }

    if (ds.en_b)
    {
        HAL_ROM::WriteBufferBytes(addressWrite, UnPack()->ch_b, ds.BytesInChannel());
    }

    return true;
}


void PacketROM::Erase() const
{
    uint data = STATE_ERASED;

    HAL_ROM::WriteBufferBytes(Address(), &data, 4);
}


int PacketROM::GetPackedSize(const DataSettings *ds)
{
    uint size = sizeof(PacketROM) +     // Packet
        sizeof(DataSettings) +          // DataSettings
        ds->NeedMemoryForData();        // data

    return (int)(size);
}


void PacketROM::Log() const
{
//    const DataSettings *ds = UnPack();
//
//    int numInROM = ds ? (int)(ds->numInROM) : -1;
//    uint address = Address();
//    int numSector = Sector::Number(Address());
//    PacketROM *next = Next();
//
//    LOG_WRITE("PacketROM : data %d, address 0x%x(sector %d), next 0x%x(sector %d)",
//        numInROM,
//        address,
//        numSector,
//        next,
//        Sector::Number((uint>(Next())));
//
//    if (ds)
//    {
//        ds->Log();
//    }
//    else
//    {
//        LOG_WRITE("Пакет стёрт либо пуст");
//    }
}


uint Sector::End() const
{
    return address + size;
}


bool Sector::ExistPackets() const
{
    return !FirstPacket()->IsFree();
}


static void WriteToROM(uint *address, const void *data, int size)
{
    HAL_ROM::WriteBufferBytes(*address, data, size);
    *address += size;
}


void Sector::TranslateAddressToROM(const DataSettings *ds, const PacketROM *packet)
{
    uint8 *addressData = (uint8 *)(packet->Address() + sizeof(PacketROM) + sizeof(DataSettings)); // По этому адресу будут записаны данные первого из записываемых каналов

    if (ds->en_a)
    {
        ((DataSettings *)(ds))->ch_a = addressData;
        addressData += ds->BytesInChannel();
    }

    if (ds->en_b)
    {
        ((DataSettings *)(ds))->ch_b = addressData;
    }
}


const PacketROM *Sector::WriteData(uint numInROM, const DataSettings *ds) const
{
    const PacketROM *packet = FirstFreePacket();

    if (packet == nullptr)
    {
        return nullptr;
    }

    uint recordAddress = packet->Address();

    uint end = End();

    uint sizePacket = sizeof(PacketROM);

    uint sizeDS = sizeof(DataSettings);

    uint sizeData = (uint)(ds->BytesInChannel() * 2);

    volatile uint needSpace = sizePacket + sizeDS + sizeData;

    needSpace = needSpace;

    volatile uint existSpace = end - recordAddress;

    existSpace = existSpace;

    if (packet->Address() + PacketROM::GetPackedSize(ds) > End() - 10)      // Если пакет при записи вылезет за границу сектора. Даём запас - в конце сектора должны остаться миниму 4 байта,
    {                                                                    // помеченные 0xFFFFFFFF во избежание лишних проверок за выход за пределы сектора.
        return nullptr;
    }

    PacketROM record = { STATE_VALID, (uint16)(PacketROM::GetPackedSize(ds)), TYPE_DATA };

    WriteToROM(&recordAddress, &record, sizeof(record));

    ((DataSettings *)ds)->numInROM = numInROM;

    uint8 *addressDataA = ds->ch_a;   // По этим адресам хранятся данные, подлежащие записи. Сохраним их перед тем, как в ds будут записаны новые - по которым данные будут храниться в ROM.
    uint8 *addressDataB = ds->ch_b;   // По этим адресам хранятся данные, подлежащие записи. Сохраним их перед тем, как в ds будут записаны новые - по которым данные будут храниться в ROM.

    TranslateAddressToROM(ds, packet);

    WriteToROM(&recordAddress, ds, sizeof(DataSettings));

    if (ds->en_a)
    {
        WriteToROM(&recordAddress, addressDataA, ds->BytesInChannel());
    }

    if (ds->en_b)
    {
        WriteToROM(&recordAddress, addressDataB, ds->BytesInChannel());
    }

    return packet;
}


const PacketROM *Sector::FindValidPacket(uint numInROM) const
{
    const PacketROM *packet = FirstPacket();

    while (packet && !packet->IsFree())
    {
        if (packet->IsData())
        {
            const DataSettings *ds = packet->UnPack();

            if (ds && ds->numInROM == numInROM)
            {
                for (int j = 0; j < ds->BytesInChannel(); j++)
                {
                    if (ds->en_a)
                    {
                        if (ds->ch_a[j] != (uint8)(j))
                        {
                            return packet;
                        }
                    }
                    if (ds->en_b)
                    {
                        if (ds->ch_b[j] != (uint8)(j))
                        {
                            return packet;
                        }
                    }
                }

                return packet;
            }
        }

        packet = packet->Next();
    }

    return nullptr;
}


const DataSettings *Sector::ReadData(uint numInROM) const
{
    const PacketROM *packet = FindValidPacket(numInROM);

    if (packet)
    {
        return packet->UnPack();
    }

    return nullptr;
}


const PacketROM *Sector::DeleteData(uint numInROM) const
{
    const PacketROM *packet = FindValidPacket(numInROM);

    if (packet)
    {
        packet->Erase();
        return packet;
    }

    return nullptr;
}


const PacketROM *Sector::FirstPacket() const
{
    return (const PacketROM *)address;
}


const PacketROM *Sector::FirstFreePacket() const
{
    const PacketROM *packet = FirstPacket();

    while (packet)
    {
        if (packet->IsFree())
        {
            return packet;
        }

        packet = packet->Next();
    }

    return nullptr;
}


void Sector::GetDataInfo(bool existData[ROM::Data::MAX_NUM_SAVED_WAVES]) const
{
    const PacketROM *packet = FirstPacket();

    while (packet && !packet->IsFree())
    {
        if (packet->IsData())
        {
            const DataSettings *ds = packet->UnPack();
            if (ds)
            {
                existData[ds->numInROM] = true;
            }
        }
        packet = packet->Next();
    }
}


uint Sector::GetNumberWornBytes() const
{
    uint result = 0;

    const PacketROM *packet = FirstPacket();

    while (packet && !packet->IsFree())
    {
        if (packet->IsErased())
        {
            result += packet->Size();
        }

        packet = packet->Next();
    }

    return result;
}


const PacketROM *Sector::GetFirstPacketWithData() const
{
    const PacketROM *result = FirstPacket();

    while (result && !result->IsFree())
    {
        if (result->IsValid())
        {
            return result;
        }

        result = result->Next();
    }

    return nullptr;
}


int Sector::Number(uint address)
{
    if (address < ADDR_SECTOR(0))
    {
        return -1;
    }

    for (int i = 0; i < Sector::Count; i++)
    {
        if (address < END_SECTOR(i))
        {
            return i;
        }
    }

    return -1;
}


const Sector &Sector::Get(uint address)
{
    return HAL_ROM::sectors[Number(address)];
}


const Sector &Sector::Get(Sector::E number)
{
    return HAL_ROM::sectors[number];
}


char *TypePacket(const PacketROM *packet)
{
    if (packet == nullptr)
    {
        return "nullptr";
    }

    if (packet->IsErased())
    {
        return "erased";
    }

    if (packet->IsFree())
    {
        return "free";
    }

    if (packet->IsData())
    {
        return "data";
    }

    return "not determinated";
}

int NumberPacket(const PacketROM *packet)
{
    const DataSettings *ds = packet->UnPack();

    if (ds == nullptr)
    {
        return -1;
    }

    return (int)(ds->numInROM);
}


void Sector::Log() const
{
//    LOG_WRITE("    Сектор %d адрес 0x%x, размер 0x%x", number, address, size);
//    LOG_WRITE("             #   адрес  размер  следующий");
//
//    PacketROM *packet = (PacketROM *>(address);
//
//    static int counter = 0;
//    counter = 0;
//
//    while (packet)
//    {
//        LOG_WRITE("%2d : %6s %2d 0x%x 0x%4x 0x%x",
//            counter,
//            TypePacket(packet),
//            NumberPacket(packet),
//            packet->Address(),
//            packet->Size(),
//            packet->Next());
//
//        packet = packet->Next();
//        counter++;
//    }
}
