Sasha7b9Work/S8-57M/sources/Device/src/Hardware/HAL/HAL.cpp

// (c) Aleksandr Shevchenko e-mail : Sasha7b9@tut.by
#include "defines.h"
#include "Hardware/PowerBreaker.h"
#include "Hardware/HAL/HAL.h"
#include <stm32f4xx_hal.h>


static void SystemClockConfig();


void HAL::Init()
{
    HAL_NVIC_SetPriorityGrouping(NVIC_PRIORITYGROUP_4);

    /* System interrupt init*/
    /* MemoryManagement_IRQn interrupt configuration */
    HAL_NVIC_SetPriority(MemoryManagement_IRQn, 0, 0);
    /* BusFault_IRQn interrupt configuration */
    HAL_NVIC_SetPriority(BusFault_IRQn, 0, 0);
    /* UsageFault_IRQn interrupt configuration */
    HAL_NVIC_SetPriority(UsageFault_IRQn, 0, 0);
    /* SVCall_IRQn interrupt configuration */
    HAL_NVIC_SetPriority(SVCall_IRQn, 0, 0);
    /* DebugMonitor_IRQn interrupt configuration */
    HAL_NVIC_SetPriority(DebugMonitor_IRQn, 0, 0);
    /* PendSV_IRQn interrupt configuration */
    HAL_NVIC_SetPriority(PendSV_IRQn, 0, 0);
    /* SysTick_IRQn interrupt configuration */
    HAL_NVIC_SetPriority(SysTick_IRQn, 0, 0);

    HAL_Init();

    RCC->AHB1ENR |= RCC_AHB1ENR_GPIOAEN;
    RCC->AHB1ENR |= RCC_AHB1ENR_GPIOBEN;
    RCC->AHB1ENR |= RCC_AHB1ENR_GPIOCEN;
    RCC->AHB1ENR |= RCC_AHB1ENR_GPIODEN;
    RCC->AHB1ENR |= RCC_AHB1ENR_GPIOEEN;
    RCC->AHB1ENR |= RCC_AHB1ENR_GPIOFEN;
    RCC->AHB1ENR |= RCC_AHB1ENR_GPIOGEN;
    RCC->AHB1ENR |= RCC_AHB1ENR_GPIOHEN;
    RCC->AHB1ENR |= RCC_AHB1ENR_GPIOJEN;

    SystemClockConfig();

    PowerBreaker::Init();

    HAL_CRC32::Init();

    HAL_BUS::Init();

    HAL_SPI4::Init();

    HAL_PCD::Init();

    HAL_HCD::Init();
}


static void SystemClockConfig()
{
    RCC_OscInitTypeDef RCC_OscInitStruct;
    RCC_ClkInitTypeDef RCC_ClkInitStruct;

    /**Configure the main internal regulator output voltage
    */
    __HAL_RCC_PWR_CLK_ENABLE();

    __HAL_PWR_VOLTAGESCALING_CONFIG(PWR_REGULATOR_VOLTAGE_SCALE3);

    /**Initializes the CPU, AHB and APB busses clocks
    */
    RCC_OscInitStruct.OscillatorType = RCC_OSCILLATORTYPE_HSE;
    RCC_OscInitStruct.HSEState = RCC_HSE_ON;
    RCC_OscInitStruct.PLL.PLLState = RCC_PLL_ON;
    RCC_OscInitStruct.PLL.PLLSource = RCC_PLLSOURCE_HSE;
    RCC_OscInitStruct.PLL.PLLM = 15;
    RCC_OscInitStruct.PLL.PLLN = 144;
    RCC_OscInitStruct.PLL.PLLP = RCC_PLLP_DIV2;
    RCC_OscInitStruct.PLL.PLLQ = 5;
    if (HAL_RCC_OscConfig(&RCC_OscInitStruct) != HAL_OK)
    {
        ERROR_HANDLER();
    }

    /**Initializes the CPU, AHB and APB busses clocks
    */
    RCC_ClkInitStruct.ClockType = RCC_CLOCKTYPE_HCLK | RCC_CLOCKTYPE_SYSCLK
        | RCC_CLOCKTYPE_PCLK1 | RCC_CLOCKTYPE_PCLK2;
    RCC_ClkInitStruct.SYSCLKSource = RCC_SYSCLKSOURCE_PLLCLK;
    RCC_ClkInitStruct.AHBCLKDivider = RCC_SYSCLK_DIV1;
    RCC_ClkInitStruct.APB1CLKDivider = RCC_HCLK_DIV4;
    RCC_ClkInitStruct.APB2CLKDivider = RCC_HCLK_DIV2;

    if (HAL_RCC_ClockConfig(&RCC_ClkInitStruct, FLASH_LATENCY_3) != HAL_OK)
    {
        ERROR_HANDLER();
    }

    /**Configure the Systick interrupt time
    */
    HAL_SYSTICK_Config((uint32_t)(HAL_RCC_GetHCLKFreq() / 1000));

    //HAL_SYSTICK_CLKSourceConfig(SYSTICK_CLKSOURCE_HCLK);

    SysTick->CTRL |= SYSTICK_CLKSOURCE_HCLK;

    /* SysTick_IRQn interrupt configuration */
    HAL_NVIC_SetPriority(SysTick_IRQn, 0, 0);
}


void HAL::ErrorHandler(pchar , int)
{
    while (true) {}
}


void HAL::Delay(uint timeMS)
{
    HAL_Delay(timeMS);
}


uint HAL::TimeMS()
{
    return HAL_GetTick();
}
