Sasha7b9Work/S8-57M/sources/Device/src/Osci/Osci.h

// (c) Aleksandr Shevchenko e-mail : Sasha7b9@tut.by
#pragma once
#include "Settings/Settings.h"
#include "Utils/Buffer.h"
#include "Hardware/HAL/HAL_PINS.h"


#define OSCI_IN_MODE_P2P        (S_TIME_BASE >= TBase::MIN_P2P)
#define OSCI_IN_MODE_RANDOMIZER (S_TIME_BASE <= TBase::MAX_RAND)



namespace OsciStateWork
{
    enum E
    {
        Stopped,        // Осциллограф в состоянии останова
        Awaiting,       // Осциллограф в состоянии ожидания синхронизации
        Triggered       // Синхронизировани
    };

    OsciStateWork::E Current();
};



namespace Osci
{
    void Init();

    void Update();

    void OnPressButtonStart();

    void DeInit();

    // (Если button == true) - это запуск кнопкой
    void Start(bool button);

    void Stop();

    bool IsRunning();

    // Это вызываем в случае изменения настройки
    void Restart();

    // Эту функцию надо вызывать при изменении длины памяти. Ну или режима пикового детектора
    void OnChangedLengthMemoryChannel();

    // Эту функцию нужно вызывать при изменении режима запуска
    void ChangedTrigStartMode();

    // Очистка данных рандомизатора при переключении режимов
    void ClearDataRand();

    void ReadData();

    uint16 ReadLastRecord(Ch::E);

    // Обработать флаг предзапуска
    void ProcessFlagPred();

    // Выполнить поиск сигнала
    void RunAutoSearch();

    // Послать данные в SCPI, если это необходимо
    void SendDataToSCPI();

    // Управитель входными цепями
    struct CircuitController
    {
        static void Init();
        static void Write(HPort::E port, uint16 pin, uint16 value);
    };
};


namespace Roller
{
    // Эту функцию нужно постоянно вызывать во время выполнения программы для чтения точек поточечного фрейма, если мы находимся в поточечном режиме
    void ReadPoint();

    // Возвращает true, если нужно рисовать поточечный фрейм
    bool NeedDraw();

    // Возвращает указатель на данные, которые нужно рисовать
    DataSettings *GetDS();

    // Заполняет buffer точками для отрисовки. width - ширина окна для отрисовки. Возвращает позицию, в которой нужно рисовать разделитель
    int FillScreenBuffer(Ch::E, Buffer &buffer, int width);

    namespace Event
    {
        // Событие на старт
        void OnStart();

        // Событие на чтение данных
        void OnReadData();
    }
};


struct ShiftPoint
{
    ShiftPoint() : shift(0xffffffff) {}

    int shift;

    bool IsValid() const { return shift != 0xffffffff; }
};
