Sasha7b9Work/S8-57M/sources/Device/src/Hardware/Memory/ROM.cpp

// (c) Aleksandr Shevchenko e-mail : Sasha7b9@tut.by
#include "defines.h"
#include "Hardware/Memory/ROM.h"
#include "Settings/Settings.h"
#include "Hardware/HAL/HAL.h"
#include "Hardware/Memory/Sector.h"
#include <cstring>


#define READ_BYTE(address)  (*((uint8 *)address))
#define SIZE_RECORD         512                      // Размер одной записи


struct Record;

/*
    В каждом секторе расположено (128 * 1024 / SIZE_RECORD) записей
*/

struct SectorSet
{
    // Возвращает адрес первой записи (фактически, начало сектора)
    Record *FirstRecord();

    // Возвращает указатель на последнюю запись с настройкаи
    Record *LastSaved();

    // Возвращает указатель на ближайшую к record пустую запись (такую, в которую можно записать настройки). Если таковой не имеется, возвращает nullptr
    Record *NextFree(Record *record);

    // Возвращает адрес первой свободной для сохранения записи
    Record *FirstFree();

    // Возвращает true, если запись record принадлежит этому сектору
    bool Contains(Record *record);

    // Проверить и исправить найденные ошибки
    void CheckAndCorrect();

    Sector sector;
};


struct Record
{
public:

    // Возвращает указатель на последнюю пустую запись (запись, в которую можно сохранить настройки)
    Record *NextFree();

    // Возвращает указатель на следующую запись
    Record *Next();

    // Возвращает true, если запись свободна (в неё ещё ничего не сохраняли, первый байты 0xFFFFFFFF)
    bool IsFree();

    // Возвращает true, если в записи что-то записано (первые байты не равны 0xFFFFFFFF и 0x00000000). Без учёта контрольных сумм
    bool IsSaved();

    // Стереть запись. Заполняет запись нулями. Это нужно делать с повреждёнными записями (с теми, в которых не совпадают контрольные суммы)
    void Erase();

    // Возвращает true, если запиь корректна. Эта происходит в следущих случаях :
    // 1 - Запись пуста (первые байты  0xFFFFFFFF)
    // 2 - Запись стёрта (первый байты 0x00000000)
    // 3 - Запись хранит настройки и контрольные суммы совпадают
    bool IsCorrect();

    // Возвращает сектор, которому принадлежит данная запись
    SectorSet *GetSector();

    // Возвращает указатель на другой сектор
    SectorSet *GetAnotherSector();

    // Возвращает указатель на первое слово записи
    uint *FirstDowbleWord();

    Settings set;
};


static SectorSet sectorFirst = { Sector::Get(Sector::_10_SETTINGS_1) };
static SectorSet sectorSecond = { Sector::Get(Sector::_11_SETTINGS_2) };


// Возвращает указатель на последнюю сохранённую запись
static Record *LastSaved();


void ROM::Init()
{
    ROM::Settings::CheckMemory();
}


void ROM::Settings::Erase()
{
    sectorFirst.sector.Erase();
    sectorSecond.sector.Erase();
}


void ROM::Settings::Save()
{
    Record *record = nullptr;

    Record *lastSaved = LastSaved();

    if(lastSaved)
    {
        record = lastSaved->GetSector()->FirstFree();

        if(!record)
        {
            SectorSet *sector = lastSaved->GetAnotherSector();
            
            record = sector->FirstFree();

            if(!record)
            {
                sector->sector.Erase();

                record = sector->FirstFree();
            }
        }
    }
    else
    {
        record = sectorFirst.FirstFree();
    }

    set.number = lastSaved ? (lastSaved->set.number + 1) : 0;                // Если запись пустая, то номер будет равен 0 = 0xFFFFFFFF + 1
    set.crc32 = set.CalcWriteCRC32();

    HAL_ROM::WriteBufferBytes((uint)record, &set, sizeof(set));
}


bool ROM::Settings::Load()
{
    Record *record = LastSaved();

    if(record)
    {
        std::memcpy(&set, &record->set, sizeof(record->set));
    }

    return (record != nullptr);
}


void ROM::Settings::CheckMemory()
{
    sectorFirst.CheckAndCorrect();
    sectorSecond.CheckAndCorrect();
}


String OTP::GetSerialNumber(int *freeForWrite)
{
    char buffer[20];
    *freeForWrite = HAL_OTP::GetSerialNumber(buffer);
    return String(buffer);
}


bool OTP::SaveSerialNumber(char *servialNumber)
{
    return HAL_OTP::SaveSerialNumber(servialNumber);
}


static Record *LastSaved()
{
    Record *saved1 = sectorFirst.LastSaved();
    Record *saved2 = sectorSecond.LastSaved();

    if (saved1 && saved2)
    {
        return (saved1->set.number > saved2->set.number) ? saved1 : saved2;
    }

    if (!saved1 && !saved2)
    {
        return nullptr;
    }

    if (!saved2)
    {
        return saved1;
    }

    return saved2;
}


Record *Record::NextFree()
{
    return GetSector()->NextFree(this);
}


Record *Record::Next()
{
    uint8 *addressThis = (uint8 *)this;

    uint8 *addressNext = addressThis + SIZE_RECORD;

    return (Record *)addressNext;
}


bool Record::IsFree()
{
    return (set.crc32 == 0xFFFFFFFFU);
}


SectorSet *Record::GetSector()
{
    if(sectorFirst.Contains(this))
    {
        return &sectorFirst;
    }

    if(sectorSecond.Contains(this))
    {
        return &sectorSecond;
    }

    return nullptr;
}


SectorSet *Record::GetAnotherSector()
{
    if(sectorFirst.Contains(this))
    {
        return &sectorSecond;
    }

    if(sectorSecond.Contains(this))
    {
        return &sectorFirst;
    }

    return nullptr;
}


bool Record::IsSaved()
{
    return (set.crc32 != 0xFFFFFFFFU) && (set.crc32 != 0x00000000U);
}


uint *Record::FirstDowbleWord()
{
    return (uint *)&set.crc32;
}


bool Record::IsCorrect()
{
    uint *start = FirstDowbleWord() + 1;
    uint *end = FirstDowbleWord() + SIZE_RECORD / 4;

    if (set.crc32 == 0xFFFFFFFFU)
    {
        for (uint *address = start; address < end; address++)
        {
            if (*address != 0xFFFFFFFFU)
            {
                return false;
            }
        }

        return true;
    }
    else if (set.crc32 == 0x00000000)
    {
        for (uint *address = start; address < end; address++)
        {
            if (*address != 0x00000000)
            {
                return false;
            }
        }

        return true;
    }
    
    return (set.crc32 == set.CalcWriteCRC32());
}


void Record::Erase()
{
    HAL_ROM::Fill((uint)this, 0, SIZE_RECORD);
}


Record *SectorSet::FirstRecord()
{
    return (Record *)sector.address;
}


bool SectorSet::Contains(Record *record)
{
    uint addressRecord = (uint)record;

    return (addressRecord >= sector.address) && (addressRecord < sector.End());
}


Record *SectorSet::NextFree(Record *record)
{
    record = record->Next();

    while(Contains(record))
    {
        if(record->IsFree())
        {
            return record;
        }
        record = record->Next();
    }

    return nullptr;
}


Record *SectorSet::LastSaved()
{
    Record *result = nullptr;

    Record *record = FirstRecord();

    while(Contains(record))
    {
        if(record->IsSaved())
        {
            if(record->IsCorrect())
            {
                if(result == nullptr)
                {
                    result = record;
                }
                else
                {
                    if(record->set.number > result->set.number)
                    {
                        result = record;
                    }
                }
            }
            else
            {
                record->Erase();
            }
        }

        record = record->Next();
    }

    return result;
}


Record *SectorSet::FirstFree()
{
    Record *record = FirstRecord();

    while(Contains(record))
    {
        if(record->IsFree())
        {
            return record;
        }

        record = record->Next();
    }

    return nullptr;
}


void SectorSet::CheckAndCorrect()
{
    Record *record = FirstRecord();

    while (Contains(record))
    {
        if (!record->IsCorrect())
        {
            record->Erase();
        }

        record = record->Next();
    }
}
