Sasha7b9Work/S8-57M/sources/Panel/src/Hardware/HAL/HAL.h

// (c) Aleksandr Shevchenko e-mail : Sasha7b9@tut.by
#pragma once


#define ERROR_HANDLER()  ::HAL::ErrorHandler(__FILE__, __LINE__)


namespace HAL
{
    void ErrorHandler(pchar , int);
};


// Используется для управления яркостью дисплея
namespace HAL_DAC2
{
    void Init();
    // Значение value от 0 до 100
    void SetValue(int value);
};


// Связь с основной платой
namespace HAL_BUS
{
    void Init();

    void SendToDevice(const uint8 *data, int size);

    void Update();
};


namespace HAL_LTDC
{
    void Init(uint buffer);

    void SetColors(uint *clut, uint numColors);
};
