Sasha7b9Work/S8-57M/sources/Device/src/Device.h

// (c) Aleksandr Shevchenko e-mail : Sasha7b9@tut.by
#pragma once
#include "Osci/Osci.h"



struct Device
{
    struct Mode
    {
        enum E
        {
            Osci,
            Tester,
            Multimeter,
            Recorder,
            Count
        } value;
        explicit Mode(E v) : value(v) {};
    };

    static void Init();

    static void Update();

    static void Reset();

    // Устанавливает режим работы
    static void SetMode(Mode::E mode);

    // Возвращает текущий режим работы
    static Mode::E CurrentMode();

    static bool InModeRecorder();

    static bool InModeOsci();
};
