Sasha7b9Work/S8-57M/sources/Device/src/Osci/ParametersOsci.h

// (c) Aleksandr Shevchenko e-mail : Sasha7b9@tut.by
#pragma once
#include "Utils/String.h"
#include "common/Display/Font/Symbols.h"


#define ChA Ch::A
#define ChB Ch::B
#define setA  set.ch[ChA]
#define setB  set.ch[ChB]


struct DataSettings;
struct SettingsChannel;


#define S_TIME_BASE (set.time.base)
namespace TBase
{
    enum E
    {
        _2ns,
        _5ns,
        _10ns,
        _20ns,
        _50ns,
        _100ns,
        _200ns,
        _500ns,
        _1us,
        _2us,
        _5us,
        _10us,
        _20us,
        _50us,
        _100us,
        _200us,
        _500us,
        _1ms,
        _2ms,
        _5ms,
        _10ms,
        _20ms,
        _50ms,
        _100ms,
        _200ms,
        _500ms,
        _1s,
        _2s,
        _5,
        _10s,
        Count
    };

    pcharc Name(TBase::E tBase);

    pcharc ToString(TBase::E tBase);

    void Set(E v = Count);

    void Change(int delta);

    // С этого значения должен включаться режим поточечного вывода
    const E MIN_P2P = _50ms;

    const E MAX_RAND = _100ns;

    // Минимальный масштаб по времени, при котором ещё возможно включение режима пикового детектора
    const E MIN_PEAK_DET = _5us;

    // Расстояние между точками в режиме рандомизатора
    int DeltaPointRand();

    // Время между точками
    float TimePoint(TBase::E base);
};


// Делитель.
#define S_DIVIDER(channel)  (set.ch[channel].divider)
#define S_DIVIDER_A         S_DIVIDER(0)
#define S_DIVIDER_B         S_DIVIDER(1)
#define S_DIVIDER_MATH      (set.math.divider)
namespace Divider
{
    enum E
    {
        _1,
        _10
    };

    inline int ToAbs(Divider::E v)
    {
        return (v == _1) ? 1 : 10;
    };
};


#define S_RANGE(channel)    set.ch[channel].range
#define S_RANGE_A           S_RANGE(0)
#define S_RANGE_B           S_RANGE(1)
#define S_RANGE_MATH        set.math.range
namespace Range
{
    enum E
    {
        _2mV,
        _5mV,
        _10mV,
        _20mV,
        _50mV,
        _100mV,
        _200mV,
        _500mV,
        _1V,
        _2V,
        _5V,
        _10V,
        _20V,
        Count
    };

    void Set(Ch::E, E range);

    pcharc Name(Ch::E);

    pcharc ToString(Ch::E, Divider::E divider);

    pcharc ToString(Range::E range, Divider::E divider);

    // Возвращает напряжение, соответствующее верхней границе сетки
    float MaxVoltageOnScreen(Range::E range);

    void Change(Ch::E, int16 delta);

    // Загружаться эта настройка может только для обоих каналов одновременно
    void LoadBoth();
};


namespace RShift
{
    // Этим конструктором можно установить значение
    void Set(Ch::E, int16 rShift);

    // Изменить на delta
    void Change(Ch::E, int16 delta);

    // Загрузить в аппаратуру
    void Load(Ch::E);

    // Отрисовать оба на экране
    void DrawBoth();

    // Преобразовать в строку
    String ToString(int16 rShiftRel, Range::E range, Divider::E divider);

    float ToAbs(int16 rShift, Range::E range);

    int16 ToRel(float rShiftAbs, Range::E range);

    bool ChangeMath(int delta);
};

// Режим канала по входу.
#define S_MODE_COUPLE(chan)         (set.ch[chan].couple)
#define S_MODE_COUPLE_A             S_MODE_COUPLE(ChA)
#define S_MODE_COUPLE_B             S_MODE_COUPLE(ChB)
#define S_MODE_COUPLE_IS_DC(chan)   (S_MODE_COUPLE(chan) == ModeCouple::DC)
namespace ModeCouple
{
    enum E
    {
        DC,      // Закрытый вход
        AC,      // Открытый вход
        GND,     // Вход заземлён.
        Count
    };

    void Set(Ch::E, ModeCouple::E couple);

    SymbolUGO UGO(ModeCouple::E v);
};


#define S_BANDWIDTH(chan)           set.ch[chan].bandwidth
#define S_BANDWIDTH_IS_20MHz(chan)  (S_BANDWIDTH(chan) == Bandwidth::_20MHz)
namespace Bandwidth
{
    enum E
    {
        Full,     // Если это значение выбрано в меню КАНАЛ, то при этом положение устанавливается полоса из ОТЛАДКА-КАНАЛЫ-Полоса.
        _20MHz,
    };

    void Load(Ch::E);
};


namespace TShift
{
    void Set(int);

    int Min();
    int Max();

    void Load();

    void Change(const int delta);

    String ToString(const TBase::E tBase = TBase::Count);

    float ToAbs(const int shift, const TBase::E tBase);

    void Reset();

    void Draw();
};

namespace Trig
{
    // Возвращает true в случае наличия синхроимпульса
    bool SyncPulse();
};

namespace TrigLevel
{
    void Set(Ch::E, int16 level);

    // Загрузить уровень синхронизации в аппаратную часть
    void Load();

    // Изменить уровень синхронизации текущего иточника синхронизации на delta единиц
    void Change(int16 delta);

    // Однократно найти уровень синхронизации
    void Find();

    void Draw();
};


namespace VALUE
{
    const uint8 AVE = 127;
    const uint8 MIN = AVE - 125;
    const uint8 MAX = AVE + 125;

    // Если значение == 0, значит, его нет. Это нужно для режимов рандомизатора и поточечного вывода p2p, а также для tShift ранее считанного сигнала
    const uint8 NONE = 0;

    void PointsToVoltage(const uint8 *points, int numPoints, Range::E range, int16 rShift, float *voltage);

    void PointsFromVoltage(const float *voltage, int numPoints, Range::E range, int16 rShift, uint8 *points);

    uint8 FromVoltage(float voltage, Range::E range, int16 rShift);

    float ToVoltage(uint8 value, Range::E range, int16 rShift);
};
