Sasha7b9Work/S8-57M/sources/Device/src/Hardware/Timer.cpp

// (c) Aleksandr Shevchenko e-mail : Sasha7b9@tut.by
#include "defines.h"
#include "log.h"
#include "Timer.h"
#include <climits>
#include "Hardware/HAL/HAL.h"


namespace Timer
{
    struct TimerStruct
    {
        pFuncVV func;           // Функция таймера
        uint    dTms;           // Период срабатывания, мс
        uint    timeNextMS;     // Время следующего срабатывания. Если == 0xffffffff, то таймер неактивен
        bool    repeat;         // Если true, будет срабатывать, пока не будет вызвана функция Timer_Disable()
        uint8   notUsed0;
        uint8   notUsed1;
        uint8   notUsed2;
    };


    static TimerStruct timers[TypeTimer::Count];
    static uint timeStartLogging = 0;
    static uint timePrevPoint = 0;
    static bool busy = false;
    static uint time_frame = 0;


#undef TIME_NEXT
#define TIME_NEXT(type) (timers[type].timeNextMS)


    // Завести таймр, который остановится в timeStop мс
    static void StartTIM(uint timeStop);

    static void StopTIM();
    // Возвращает время срабатывания ближайщего таймера, либо 0, если таймеров нет
    static uint NearestTime();
    // Настроить систему на таймер
    static void TuneTIM(::TypeTimer::E type);
}


void Timer::StartFrame()
{
    time_frame = TIME_MS;
}


uint Timer::TimeFrame()
{
    return time_frame;
}


bool Timer::IsRunning(TypeTimer::E type)
{
    return TIME_NEXT(type) != UINT_MAX; //-V2523
}


void Timer::Init()
{
    for(uint i = 0; i < TypeTimer::Count; i++)
    {
        timers[i].timeNextMS = UINT_MAX; //-V2523
    }

    HAL_TIM3::Init(54000 - 1, 1);
    HAL_TIM3::EnableIRQ(1, 1);

    HAL_TIM2::Init(0, (uint)(-1));
    HAL_TIM2::Start();
}


void Timer::DeInit()
{
    HAL_TIM2::Stop();
    HAL_TIM2::DeInit();

    HAL_TIM3::DisableIRQ();
    HAL_TIM3::StopIT();
    HAL_TIM3::DeInit();
}


void Timer::SetAndEnable(TypeTimer::E type, pFuncVV func, uint dTms)
{
    Set(type, func, dTms);
    Enable(type);
}


void Timer::Disable(TypeTimer::E type)
{
    timers[type].timeNextMS = UINT_MAX; //-V2523
    timers[type].repeat = false;
}


void Timer::ElapsedCallback()
{
    uint time = TIME_MS;

    if (NearestTime() > time)
    {
        return;
    }

    StopTIM();

    for (uint type = 0; type < TypeTimer::Count; type++)
    {
        if (TIME_NEXT(type) <= time)            // Если пришло время срабатывания
        {
            TimerStruct *timer = &timers[type];
            if(timer->func)
            {
                timer->func();
            }
            if (timer->repeat)
            {
                do      // Цикл нужен потому, что системный таймер SysTick, который отсчитываем миллисекунды, имеет наивысший приоритет,
                {       // и если функция выполняется дольше, чем timer->dTm мс, то оно тут зависнет
                    timer->timeNextMS += timer->dTms;
                } while (timer->timeNextMS < TIME_MS);

            }
            else
            {
                timer->timeNextMS = UINT_MAX; //-V2523
            }
        }
    }

    StartTIM(NearestTime());
}


void Timer::Set(TypeTimer::E type, pFuncVV func, uint dTms)
{
    TimerStruct *timer = &timers[type];
    timer->func = func;
    timer->dTms = dTms;
}


void Timer::SetAndStartOnce(TypeTimer::E type, pFuncVV func, uint dTms)
{
    Timer::Set(type, func, dTms);
    StartOnce(type);
}


void Timer::StartOnce(TypeTimer::E type)
{
    timers[type].repeat = false;
    TuneTIM(type);
}


void Timer::Enable(TypeTimer::E type)
{
    timers[type].repeat = true;
    TuneTIM(type);
}


void Timer::TuneTIM(TypeTimer::E type)
{
    TimerStruct *timer = &timers[type];

    uint timeNearest = NearestTime();

    uint timeNext = TIME_MS + timer->dTms;
    timer->timeNextMS = timeNext;

    if(timeNext < timeNearest)      // Если таймер должен сработать раньше текущего
    {
        StartTIM(timeNext);         // то заводим таймер на наше время
    }
}


uint Timer::NearestTime()
{
    uint time = UINT_MAX; //-V2523

    for(uint type = 0; type < TypeTimer::Count; type++)
    {
        if(TIME_NEXT(type) < time)
        {
            time = TIME_NEXT(type);
        }
    }
    
    return time;
}


void Timer::StartTIM(uint timeStopMS)
{
    StopTIM();

    if(timeStopMS == UINT_MAX) //-V2523
    {
        return;
    }

    uint dT = timeStopMS - TIME_MS;

    HAL_TIM3::StartIT((dT * 2) - 1);             // 10 соответствует 0.1мс. Т.е. если нам нужна 1мс, нужно засылать (100 - 1)
}


void Timer::StopTIM()
{
    HAL_TIM3::StopIT();
}


void Timer::PauseOnTime(uint timeMS)
{
    HAL::Delay(timeMS);
}


void Timer::PauseOnTicks(uint numTicks)
{
    volatile uint startTicks = TIME_TICKS;

    while (TIME_TICKS - startTicks < numTicks)    {};
}


void Timer::PauseOnOPS(uint ops)
{
    volatile uint count = 0;
    for (; count < ops; count++)
    {
    }
}


void Timer::StartLogging()
{
    timeStartLogging = TIME_TICKS;
    timePrevPoint = timeStartLogging;
}


uint Timer::LogPointUS(char * name)
{
    uint interval = TIME_TICKS - timePrevPoint;
    timePrevPoint = TIME_TICKS;
    LOG_WRITE("%s %.2f us", name, interval / 120.0);
    return interval;
}


uint Timer::LogPointMS(char * name)
{
    uint interval = TIME_TICKS - timePrevPoint;
    timePrevPoint = TIME_TICKS;
    LOG_WRITE("%s %.2f ms", name, interval / 120e3);
    return interval;
}


void Timer::StartMultiMeasurement()
{
    busy = true;
    HAL_TIM2::StartMultiMeasurement();
    busy = false;
}


bool Timer::IsBusy()
{
    return busy;
}
