Sasha7b9Work/S8-57M/sources/Device/src/Hardware/VCP_stm.cpp

// (c) Aleksandr Shevchenko e-mail : Sasha7b9@tut.by
#include "defines.h"
#include "usbd_desc.h"
#include "usbd_cdc_interface.h"
#include "Hardware/VCP.h"
#include "usbd_desc.h"
#include "Utils/Math.h"
#include <cstring>
#include <cstdarg>
#include <usbd_core.h>
#include <cstdio>



namespace VCP
{
    USBD_HandleTypeDef hUSBD;
    PCD_HandleTypeDef  hPCD;

    void *VCP::handleUSBD = &hUSBD;
    void *VCP::handlePCD = &hPCD;
    bool VCP::cable_connected = false;
    bool VCP::client_connected = false;

    static bool PrevSendingComplete();
}


void VCP::Init()
{
    USBD_Init(&hUSBD, &VCP_Desc, DEVICE_FS);
    USBD_RegisterClass(&hUSBD, &USBD_CDC);
    USBD_CDC_RegisterInterface(&hUSBD, &USBD_CDC_fops);
    USBD_Start(&hUSBD);
}


bool VCP::PrevSendingComplete()
{
    USBD_CDC_HandleTypeDef *pCDC = (USBD_CDC_HandleTypeDef *)hUSBD.pClassData;
    return pCDC->TxState == 0;
}


void VCP::SendDataAsynch(const uint8 *buffer, int size)
{
#define SIZE_BUFFER 64
    static uint8 trBuf[SIZE_BUFFER];

    size = Math::Min(size, SIZE_BUFFER);
    while (!PrevSendingComplete())  {};
    std::memcpy(trBuf, buffer, (uint)size);

    USBD_CDC_SetTxBuffer(&hUSBD, trBuf, (uint16)size);
    USBD_CDC_TransmitPacket(&hUSBD);
}


#define SIZE_BUFFER_VCP 256     // \todo если поставить размер буфера 512, то на ТЕ207 глюки
static uint8 buffSend[SIZE_BUFFER_VCP];
static int sizeBuffer = 0;


void VCP::Flush()
{
    if (sizeBuffer)
    {
        volatile USBD_CDC_HandleTypeDef *pCDC = (USBD_CDC_HandleTypeDef *)hUSBD.pClassData;

        while (pCDC->TxState == 1) {}; //-V712

        USBD_CDC_SetTxBuffer(&hUSBD, buffSend, (uint16)(sizeBuffer));
        USBD_CDC_TransmitPacket(&hUSBD);

        while (pCDC->TxState == 1) {}; //-V654 //-V712
    }
    sizeBuffer = 0;
}


void VCP::SendDataSynch(const void *_buffer, int size)
{
    if (VCP::client_connected)
    {
        char *buffer = (char *)_buffer;
        if (size == 0)
        {
            size = (int)std::strlen(buffer);
        }

        volatile USBD_CDC_HandleTypeDef *pCDC = (USBD_CDC_HandleTypeDef *)hUSBD.pClassData;
    
        do 
        {
            if (sizeBuffer + size > SIZE_BUFFER_VCP)
            {
                int reqBytes = SIZE_BUFFER_VCP - sizeBuffer;
                LIMITATION(reqBytes, 0, (int)(size));

                while (pCDC->TxState == 1) {}; //-V712

                std::memcpy(buffSend + sizeBuffer, (void *)(buffer), (uint)(reqBytes));
                USBD_CDC_SetTxBuffer(&hUSBD, buffSend, SIZE_BUFFER_VCP);
                USBD_CDC_TransmitPacket(&hUSBD);
                size -= reqBytes;
                buffer += reqBytes;
                sizeBuffer = 0;
            }
            else
            {
                std::memcpy(buffSend + sizeBuffer, (void *)(buffer), (uint)(size));
                sizeBuffer += size;
                size = 0;
            }
        } while (size);
    }
}


void VCP::SendStringAsynch(pchar data)
{
    SendDataAsynch((uint8 *)data, (int)std::strlen(data));
}


void VCP::SendStringSynch(char *data)
{
    SendDataSynch((uint8 *)data, (int)std::strlen(data));
}


void VCP::SendFormatStringAsynch(char *format, ...)
{
    if (VCP::client_connected)
    {
        static char buffer[200];
        std::va_list args;
        va_start(args, format); //-V2528
        std::vsprintf(buffer, format, args);
        va_end(args);
        std::strcat(buffer, "\r\n");
        SendDataAsynch((uint8 *)buffer, (int)std::strlen(buffer));
    }
}


void VCP::SendFormatStringSynch(char *format, ...)
{
    char buffer[200];
    std::va_list args;
    va_start(args, format); //-V2528
    std::vsprintf(buffer, format, args);
    va_end(args);
    std::strcat(buffer, "\r\n");
    SendDataSynch((uint8 *)buffer, (int)std::strlen(buffer));
}


void VCP::SendByte(uint8 byte)
{
    SendDataSynch(&byte, 1);
}
