Sasha7b9Work/S8-57M/sources/Device/src/FPGA/TypesFPGA.h

// (c) Aleksandr Shevchenko e-mail : Sasha7b9@tut.by
#pragma once


struct WR
{
    static uint8 *START;        // Старт
    static uint8 *TBASE;        // Развёртка
    static uint8 *PRED_LO;      // Предзапуск
    static uint8 *PRED_HI;
    static uint8 *POST_LO;      // Послезапуск
    static uint8 *POST_HI;

    static uint8 *UPR;                      // Управление
#define BIT_UPR_RAND            0           // Вкл. рандомизатор
#define BIT_UPR_PEAK            1           // Пиковый детектор
#define BIT_UPR_CALIBR_AC_DC    2           // Калибратор AC/DC
#define BIT_UPR_CALIBR_ZERO     3           // Калибратор 0/4В

    static uint8 *FREQMETER;                // Управление частотомером
    static uint8 *TRIG;                     // Управление синхронизацией/запуском
#define BIT_TRIG_POLARITY       0           // Управление полярностью синхронизации
#define BIT_TRIG_ENABLED        1           // Бит включения сихронизации. 0 - вкл, 1 - выкл

    static uint8 *START_ADDR;               // \brief Старт адреса. Нужно записываеть по этому адресу, чтобы начать чтение с 
                                            //  произвольного адреса (который мы записываем в предзапуск)
    static uint8 *RESET_COUNTER_FREQ;       // Записывать сюда после изменения настройки частотомера для обнуления счётчика частоты
    static uint8 *RESET_COUNTER_PERIOD;     // Записывать сюда после изменения настройки частотомера для обнуления счётчика периода

    static uint8 *TRIG_HOLD_ENABLE;         // Управление задержкой синхронизации. "0" - выкл, "1" - вкл
    static uint8 *TRIG_HOLD_VALUE_LOW;      // Младший байт задержки синхронизации
    static uint8 *TRIG_HOLD_VALUE_MID;      // Значение рассчитывается по формуле N = 0 - (задержка / 100нс). Максимальная задержка - 1.5 сек
    static uint8 *TRIG_HOLD_VALUE_HI;       // Старший байт задержки синхронизации
};

struct RD
{
    static uint8 *DATA_A;               // Данные первого канала
    static uint8 *DATA_A_PEAK_MAX;      // Данные пикового детектора первого канала
    static uint8 *DATA_A_PEAK_MIN;
    static uint8 *DATA_B;               // Данные второго канала
    static uint8 *DATA_B_PEAK_MAX;      // Данные пиквого детектора второго канала
    static uint8 *DATA_B_PEAK_MIN;
    static uint8 *LAST_RECORD_LO;       // Адрес последней записи
    static uint8 *LAST_RECORD_HI;
    static uint8 *FREQ_BYTE_0;          // Измеренное значение частоты
    static uint8 *FREQ_BYTE_1;
    static uint8 *FREQ_BYTE_2;
    static uint8 *FREQ_BYTE_3;
    static uint8 *PERIOD_BYTE_0;        // Измеренное значение периода
    static uint8 *PERIOD_BYTE_1;
    static uint8 *PERIOD_BYTE_2;
    static uint8 *PERIOD_BYTE_3;
    static uint8 *FLAG_LO;              // Младший байт флага
    static uint8 *FLAG_HI;              // Старший байт флага
};

struct Flag
{
    enum E
    {
        _DATA_READY        = 0,  // Данные готовы для считывания (окончание счётчика послезапуска)
        _TRIG_READY        = 1,  // Флаг синхроимпульса
        _PRED              = 2,  // Если 1, то предзапуск отсчитал, можно давать принудительный запуск (окончание
        _P2P               = 3,  // 
        _FREQ_READY        = 4,  // Флаг готовности измерения частоты
        _PERIOD_READY      = 5,  // Флаг готовности измерения периода
        _HOLD_OFF_FLAG     = 7,  // Принудительный запуск можно давать только когда этот флаг в единице
        _FREQ_OVERFLOW     = 8,  // Признак переполнения счётчика частоты
        _PERIOD_OVERFLOW   = 9,  // Признак переполнения счётчика периода
        _FREQ_IN_PROCESS   = 10, // Установленное в единицу значение означает, что идёт процесс измерения - счётчик запущен и считает
        _PERIOD_IN_PROCESS = 11  // Установленное в единицу значение означает, что идёт процесс измерения - счётчик запущен и считает
    };
};
