Sasha7b9Work/S8-57M/sources/Device/src/Display/Symbols.h

// (c) Aleksandr Shevchenko e-mail : Sasha7b9@tut.by
#pragma once


struct Symbol5
{
    enum E
    {
        COUPLE_AC  = '\x91',
        COUPLE_DC  = '\x92',
        COUPLE_GND = '\x90'
    };
};

struct Symbol8
{
    enum E
    {
        GOVERNOR_SHIFT_3    = '\x0e',  // Символ регулятора
        GOVERNOR_LEFT       = '\x80',
        GOVERNOR_RIGHT      = '\x81',
        TSHIFT_NORMAL       = '\x84',  // Изображение смещения по времени
        TSHIFT_NORMAL_BACK  = '\x85',  // Фон для изображения смещения по времени
        TSHIFT_LEFT         = '\x86',  // Изображение смещения по времени при переходе за левую границу экрана
        TSHIFT_RIGHT        = '\x87',  // Изображение смещения по времени при переходе за правую границу экрана
        CROSS               = '\x88',  // Символ диагонального креста
        TPOS_1              = '\x8a',  // 2-я часть символа TPos
        TPOS_2              = '\x8b',  // 1-я часть символа TPos
        RSHIFT_NORMAL       = '\x93',  // Символ смещения по напряжению нормальный
        TRIGLEV_NORMAL      = '\x94',  // Символ уровень синхронизации нормальный
        TRIGLEV_LOWER       = '\x95',  // Символ уровень синхронизации ниже сетки
        TRIGLEV_ABOVE       = '\x96',  // Символ уровень синхронизации выше сетки
        GOVERNOR_SHIFT_2    = '\x8c',  // Символ регулятора
        GOVERNOR_SHIFT_0    = '\xaa',  // Символ регулятора
        GOVERNOR_SHIFT_1    = '\xac',  // Символ регулятора
        PLAY                = '\xae',  // Символ работы справа вверху экрана
        ARROW_UP            = '\xb9',
        ARROW_DOWN          = '\x9d'
    };
};

struct SymbolUGO
{
    enum E
    {
        Count
    };
};

#ifdef DELETE
#undef DELETE
#endif

struct SymbolUGO2
{
    enum E
    {
        PEAK_DET_LEFT   = '\x12',   // Левая часть значка пикового детектора
        PEAK_DET_RIGHT  = '\x13',   // Правая часть значка пикового детектора
        ARROW_LEFT      = '\x20',
        DELETE          = '\x22',   // ВНЕШН ЗУ-МАСКА-УДАЛИТЬ
        INSERT          = '\x26',   // ВНЕШН ЗУ-ИМЯ-ВСТАВИТЬ
        SAVE_TO_MEM     = '\x2c',
        ROM             = '\x40',   // Микросхемка
        FLASH_DRIVE_BIG = '\x42',   // Символ флешки
        FOLDER          = '\x46',   // Каталог
        LEAVE           = '\x48',   // Значок выхода
        ENTER           = '\x4a',   // Значок "Enter"
        TRIANGLE_UP     = '\x4c',   // Стрелка треугольником вверх
        TRIANGLE_DOWN   = '\x4e',   // Стрекла треугольником вниз
        BIG_M           = '\x60',   // Большая буква "М"
        SETTINGS        = '\x62',   // Значок настроек
        ARROW_RIGHT     = '\x64',
        TAB             = '\x6e',
        FLASH_DRIVE     = '\x80',   // Символ флешки внизу экрана
        ETHERNET        = '\x82',   // Символ Ethernet внизу экрана
        USB             = '\x84',   // Символ USB внизу экрана
        MATH_FUNC_MUL   = '\x8a',   // МАТЕМАТИКА-ФУНКЦИЯ-УМНОЖЕНИЕ
        TRIANGLE_LEFT   = '\x8c',   // Стрелка треугольником влево
        TRIANGLE_RIGHT  = '\x8e',   // Стрелка треугольником вправо
        SELECT          = '\xa0'    // Символ выбора
    };
};
