Sasha7b9Work/S8-57M/sources/Device/src/Display/Painter.h

// (c) Aleksandr Shevchenko e-mail : Sasha7b9@tut.by
#pragma once
#include "Colors.h"
#include "common/Display/Font/Font.h"


namespace Painter
{
    void Init();

    void BeginScene(int num_field, Color color);

    int CurrentField();

    void EndScene();
};
