Sasha7b9Work/S8-57M/sources/Panel/src/Log.cpp

// (c) Aleksandr Shevchenko e-mail : Sasha7b9@tut.by
#include "defines.h"
#include "Log.h"
#include "common/Command.h"
#include "Hardware/HAL/HAL.h"
#include <Display/Display.h>
#include <Hardware/CPU.h>
#include <stdarg.h>
#include <cstring>
#include <stdio.h>
#include <cstdlib>



#define SIZE_BUFFER_LOG 200

static void AddToConsole(pchar text);


void Log::Write(TypeTrace type, pchar format, ...)
{
    char buffer[SIZE_BUFFER_LOG];
    char *pointer = buffer;

    if (type == TypeTrace_Error)
    {
        buffer[0] = 0;
        std::strcat(buffer, "!!! ERROR !!! ");
        while (*pointer++) {}
        ++pointer;
    }
    va_list args;
    va_start(args, format); //-V2528
    vsprintf(pointer, format, args);
    va_end(args);
    AddToConsole(buffer);
}


void Log::Trace(TypeTrace type, pchar module, pchar func, int numLine, char *format, ...)
{
    char buffer[SIZE_BUFFER_LOG];
    char message[SIZE_BUFFER_LOG];
    va_list args;
    va_start(args, format); //-V2528
    vsprintf(buffer, format, args);
    va_end(args);
    const int SIZE = 20;
    char numBuffer[SIZE];
    snprintf(numBuffer, 19, ":%d", numLine);
    message[0] = 0;

    if (type == TypeTrace_Error)
    {
        std::strcat(message, "!!!ERROR!!! ");
    }
    else if (type == TypeTrace_Info) //-V547
    {
        std::strcat(message, "            ");
    }

    std::strcat(message, module);
    std::strcat(message, " ");
    std::strcat(message, func);
    std::strcat(message, numBuffer);
    AddToConsole(message);
    AddToConsole(buffer);
}


static void AddToConsole(pchar text)
{
    uint8 *buffer = (uint8 *)(std::malloc(std::strlen(text) + 3U));

    if (buffer)
    {
        buffer[0] = Command::AddToConsole;
        buffer[1] = (uint8)std::strlen(text);
        std::strcpy((char *)(buffer + 2), text);
        HAL_BUS::SendToDevice(buffer, (int)std::strlen(text) + 2);

        std::free(buffer);
    }
}
