Sasha7b9Work/S8-57M/sources/Device/src/Hardware/Memory/IntRAM.cpp

// (c) Aleksandr Shevchenko e-mail : Sasha7b9@tut.by
#include "defines.h"
#include "FPGA/FPGA.h"
#include "Hardware/Memory/IntRAM.h"
#include "Menu/Pages/Include/PageMemory.h"
#include "Osci/DeviceSettings.h"
#include <cstring>


namespace IntRAM
{
    static DataSettings ds;


    static uint8 buffer[106 * 1024];

    static uint16 *const memAveA = (uint16 *)buffer;                              // 0            = 0k
    static uint16 *const memAveB = (uint16 *)(buffer + 4 * FPGA::MAX_NUM_POINTS);   // 0   + 4 * 8k = 32k

    static uint8 *const memP2PA = (uint8 *)memAveB + 4 * FPGA::MAX_NUM_POINTS;    // 32k + 4 * 8k = 64k
    static uint8 *const memP2PB = memP2PA + 2 * FPGA::MAX_NUM_POINTS;                               // 64k + 2 * 8k = 80k

    static uint8 *const memRandA = memP2PA;
    static uint8 *const memRandB = memP2PB;

    static uint16 *const ave[2] = { memAveA, memAveB };
    static uint8 *const rand[2] = { memRandA, memRandB };
}


uint16 *IntRAM::Averager32k(Ch::E ch)
{
    return ave[ch];
}


uint8 *IntRAM::DataRand(Ch::E ch)
{
    return rand[ch];
}


DataSettings *IntRAM::PrepareForP2P()
{
    ds.Fill();

    ds.ch_a = ds.en_a ? memP2PA : nullptr;
    ds.ch_b = ds.en_b ? memP2PB : nullptr;

    std::memset(memP2PA, VALUE::NONE, 2 * FPGA::MAX_NUM_POINTS); //-V512 //-V1086
    std::memset(memP2PB, VALUE::NONE, 2 * FPGA::MAX_NUM_POINTS); //-V512 //-V1086

    return &ds;
}
