Sasha7b9Work/S8-57M/sources/Device/src/Hardware/Memory/IntRAM.h

// (c) Aleksandr Shevchenko e-mail : Sasha7b9@tut.by
#pragma once
#include "Osci/ParametersOsci.h"


namespace IntRAM
{
    // Указатель на 16k байт памяти, предназначенной для работы усреднителя
    uint16 *Averager32k(Ch::E);

    // Память для чтения канала в режиме рандомизатора
    uint8 *DataRand(Ch::E);

    // Указатель на данные поточечного фрейма
    DataSettings *PrepareForP2P();
};
