Sasha7b9Work/S8-57M/sources/Device/src/Tables.h

// (c) Aleksandr Shevchenko e-mail : Sasha7b9@tut.by
#pragma once
#include "Settings/Settings.h"



class Tables
{
public:
    static ENumSignalsInSec::E ENumSignalsInSecToENUM(int numSignalsInSec);
    
    static pcharc Get(int index);
    // Выводит строку из таблицы symbolsAlphaBet
    static void DrawStr(int index, int x, int y);

    static int Size();

private:
    static pcharc symbolsAlphaBet[0x48];
};
