Sasha7b9Work/S8-57M/sources/Device/src/Hardware/HAL/HAL_IT.cpp

// (c) Aleksandr Shevchenko e-mail : Sasha7b9@tut.by
#include "defines.h"
#include "log.h"
#include "Hardware/Timer.h"
#include "Hardware/VCP.h"
#include "Hardware/HAL/HAL.h"
#include "Hardware/HAL/HAL_PINS.h"
#include "Utils/Debug.h"
#include <stm32f4xx_hal.h>


INTERRUPT_BEGIN



void HardFault_Handler()
{
    __IO pchar file0 = Debug::file[0];
    __IO pchar file1 = Debug::file[1];
    __IO int line0 = Debug::line[0];
    __IO int line1 = Debug::line[1];
    __IO int line2 = Debug::line[2];
    
    while (1) //-V776
    {
        file0 = file0; //-V570
        file1 = file1; //-V570
        line0 = line0; //-V570
        line1 = line1; //-V570
        line2 = line2; //-V570

        NVIC_SystemReset();
    }
}


void TIM3_IRQHandler()
{
    if ((TIM3->SR & TIM_SR_UIF) == TIM_SR_UIF)
    {
        if ((TIM3->DIER & TIM_DIER_UIE) == TIM_DIER_UIE)
        {
            TIM3->SR = ~TIM_DIER_UIE;
            Timer::ElapsedCallback();
        }
    }
}

/*
void TIM5_IRQHandler()
{
    if ((TIM5->SR & TIM_SR_UIF) == TIM_SR_UIF)
    {
        if ((TIM5->DIER & TIM_DIER_UIE) == TIM_DIER_UIE)
        {
            TIM5->SR = ~TIM_DIER_UIE;

            HAL_TIM5::ElapsedCallback();
        }
    }
}
*/


void SysTick_Handler(void)
{
    HAL_IncTick();
}


void EXTI9_5_IRQHandler(void)
{
    HAL_GPIO_EXTI_IRQHandler(GPIO_PIN_9);       // Тестер компонентов
}


// VCP
void OTG_FS_IRQHandler()
{
    HAL_PCD_IRQHandler((PCD_HandleTypeDef *)VCP::handlePCD);
}


// Флешка
void OTG_HS_IRQHandler()
{
//    static uint startFrame = 0;
//
//    static uint counterTicks = 0;
//
//    uint start = TIME_TICKS;
//
//    HAL_HCD_IRQHandler(&HAL_HCD::handle);
//
//    uint end = TIME_TICKS;
//
//    counterTicks += (end - start);
//
//    if(TIME_MS - startFrame >= 1000)
//    {
//        LOG_WRITE("мс на прерывание за секунду %d", counterTicks / 1000 / 90);
//        counterTicks = 0;
//        startFrame = TIME_MS;
//        Timer::StartMultiMeasurement();
//    }


    HAL_HCD_IRQHandler((HCD_HandleTypeDef *)HAL_HCD::handleHCD);
}



void NMI_Handler(void)
{
}


void MemManage_Handler()
{
    while (1)
    {
        NVIC_SystemReset();
    }
}


void BusFault_Handler()
{
    while (1)
    {
        NVIC_SystemReset();
    }
}


void UsageFault_Handler()
{
    while (1)
    {
        NVIC_SystemReset();
    }
}


void SVC_Handler(void)
{
}


void DebugMon_Handler(void)
{
}


void PendSV_Handler(void)
{
}

INTERRUPT_END
