Sasha7b9Work/S8-57M/sources/Device/src/Hardware/HAL/HAL_OTP.cpp

// (c) Aleksandr Shevchenko e-mail : Sasha7b9@tut.by
#include "defines.h"
#include "HAL.h"
#include <stm32f4xx_hal.h>
#include <cstring>


int HAL_OTP::GetSerialNumber(char buffer[17])
{
    // \todo улучшить - нельзя разбрасываться байтами. Каждая запись должна занимать столько места, сколько в ней символов, а не 16, как сейчас.

    const int allShotsMAX = 512 / 16;   // Максимальное число записей в OTP серийного номера.

    uint8 *address = (uint8 *)(FLASH_OTP_END - 15U); //-V566

    do
    {
        address -= 16;
    } while (*address == 0xff && address > (uint8 *)FLASH_OTP_BASE); //-V566

    if (*address == 0xff)   // Не нашли строки с информацией, дойдя до начального адреса OTP
    {
        buffer[0] = 0;
        return allShotsMAX;
    }

    std::strcpy(buffer, (pchar)address);

    return allShotsMAX - (address - (uint8 *)FLASH_OTP_BASE) / 16 - 1; //-V566
}


bool HAL_OTP::SaveSerialNumber(char *servialNumber)
{
    // Находим первую пустую строку длиной 16 байт в области OTP, начиная с начала
    uint8 *address = (uint8 *)FLASH_OTP_BASE; //-V566

    while ((*address) != 0xff &&                    // *address != 0xff означает, что запись в эту строку уже производилась
        address < (uint8 *)FLASH_OTP_END - 16) //-V566
    {
        address += 16;
    }

    if (address < (uint8 *)FLASH_OTP_END - 16) //-V566
    {
        HAL_ROM::WriteBufferBytes((uint)address, (void *)servialNumber, (int)(std::strlen(servialNumber) + 1));
        return true;
    }

    return false;
}
