Sasha7b9Work/S8-57M/sources/Device/src/Hardware/HAL/HAL_RTC.cpp

// (c) Aleksandr Shevchenko e-mail : Sasha7b9@tut.by
#include "defines.h"
#include "Hardware/HAL/HAL.h"
#include "Hardware/Timer.h"
#include <stm32f4xx_hal.h>


#define VALUE_FOR_RTC 0x644


#define RTC_ASYNCH_PREDIV 0x7f
#define RTC_SYNCH_PREDIV 0x00ff


static RTC_HandleTypeDef handleRTC =
{
    RTC,
    {
        RTC_HOURFORMAT_24,          // HourFormat
        RTC_ASYNCH_PREDIV,          // AsynchPrediv
        RTC_SYNCH_PREDIV,           // SynchPrediv
        RTC_OUTPUT_DISABLE,         // OutPut
        RTC_OUTPUT_POLARITY_HIGH,   // OutPutPolarity
        RTC_OUTPUT_TYPE_OPENDRAIN   // OutPutType
    }
};



void HAL_RTC::Init()
{
    RCC_OscInitTypeDef        RCC_OscInitStruct;
    RCC_PeriphCLKInitTypeDef  PeriphClkInitStruct;

    __HAL_RCC_PWR_CLK_ENABLE();

    HAL_PWR_EnableBkUpAccess();

    RCC_OscInitStruct.OscillatorType = RCC_OSCILLATORTYPE_LSE;
    RCC_OscInitStruct.PLL.PLLState = RCC_PLL_NONE;
    RCC_OscInitStruct.LSEState = RCC_LSE_ON;
    RCC_OscInitStruct.LSIState = RCC_LSI_OFF;

    if (HAL_RCC_OscConfig(&RCC_OscInitStruct) != HAL_OK)
    {
        ERROR_HANDLER();
    }

    PeriphClkInitStruct.PeriphClockSelection = RCC_PERIPHCLK_RTC;
    PeriphClkInitStruct.RTCClockSelection = RCC_RTCCLKSOURCE_LSE;

    if (HAL_RCCEx_PeriphCLKConfig(&PeriphClkInitStruct) != HAL_OK)
    {
        ERROR_HANDLER();
    }
    
    __HAL_RCC_RTC_ENABLE();

    if(HAL_RTC_Init(&handleRTC) != HAL_OK)
    {
        ERROR_HANDLER();
    }

    if (HAL_RTCEx_BKUPRead(&handleRTC, RTC_BKP_DR0) != VALUE_FOR_RTC)
    {
        if (SetPackedTime(PackedTime()))
        {
            HAL_RTCEx_BKUPWrite(&handleRTC, RTC_BKP_DR0, VALUE_FOR_RTC);
        }
    }
}


PackedTime HAL_RTC::GetPackedTime()
{
    PackedTime time;

    RTC_TimeTypeDef isTime;

    HAL_RTC_GetTime(&handleRTC, &isTime, FORMAT_BIN);

    time.hours = isTime.Hours;
    time.minutes = isTime.Minutes;
    time.seconds = isTime.Seconds;

    RTC_DateTypeDef isDate;
    HAL_RTC_GetDate(&handleRTC, &isDate, FORMAT_BIN);

    time.year = isDate.Year;
    time.month = isDate.Month;
    time.day = isDate.Date;

    return time;
}


bool HAL_RTC::SetPackedTime(const PackedTime &time)
{
    RTC_DateTypeDef dateStruct;
    dateStruct.WeekDay = RTC_WEEKDAY_MONDAY;
    dateStruct.Month = (uint8)(time.month);
    dateStruct.Date = (uint8)(time.day);
    dateStruct.Year = (uint8)(time.year);

    if (HAL_RTC_SetDate(&handleRTC, &dateStruct, FORMAT_BIN) != HAL_OK)
    {
        return false;
    };

    RTC_TimeTypeDef timeStruct;
    timeStruct.Hours = (uint8)(time.hours);
    timeStruct.Minutes = (uint8)(time.minutes);
    timeStruct.Seconds = (uint8)(time.seconds);
    timeStruct.TimeFormat = RTC_HOURFORMAT_24;
    timeStruct.DayLightSaving = RTC_DAYLIGHTSAVING_NONE;
    timeStruct.StoreOperation = RTC_STOREOPERATION_SET;

    if (HAL_RTC_SetTime(&handleRTC, &timeStruct, FORMAT_BIN) != HAL_OK)
    {
        return false;
    };

    return true;
}
