Sasha7b9Work/S8-57M/sources/Panel/src/Log.h

// (c) Aleksandr Shevchenko e-mail : Sasha7b9@tut.by
#pragma once


#if defined(DEBUG) && !defined(WIN32)
#define LOG_WRITE(...)          Log::Write(TypeTrace_Info, __VA_ARGS__)
#define LOG_ERROR(...)          Log::Write(TypeTrace_Error, __VA_ARGS__)
#define LOG_WRITE_TRACE(...)    Log::Trace(TypeTrace_Info, __MODULE__, __FUNCTION__, __LINE__, __VA_ARGS__)
#define LOG_ERROR_TRACE(...)    Log::Trace(TypeTrace_Error, __FILE__, __FUNCTION__, __LINE__, __VA_ARGS__)
// Когда нужен вспомогательный буфер для преобразования числа в строку, можно пользоваться этой функцией
#define LOG_WRITE_BUF(...)      { char buffer[100]; Log_Write(TypeTrace_Info, __VA_ARGS__); }
#define LOG_FUNC_ENTER()        Log::Write(TypeTrace_Info, "%s enter", __FUNCTION__);
#define LOG_FUNC_LEAVE()          Log::Write(TypeTrace_Info, "%s leave", __FUNCTION__);
#define LOG_TRACE               Log::Write(TypeTrace_Info, "%s : %d", __FILE__, __LINE__);
#define ASSEERT(cond, ...)      if(cond)(LOG_ERROR_TRACE(__VA_ARGS__));
#define ASSERT_RET(cond, ...)   if(cond) {LOG_ERROR_TRACE(__VA_ARGS__); return; }
#elif defined(WIN32)
#define ASSERT_RET(cont, ...)
#define LOG_ERROR_TRACE(...)
#define LOG_WRITE(...)          Log::Write(TypeTrace_Info, __VA_ARGS__)
#define LOG_TRACE
#define LOG_ERROR(...)          Log::Write(TypeTrace_Error, __VA_ARGS__)
#define LOG_FUNC_ENTER()
#define LOG_FUNC_LEAVE()
#else
#define LOG_WRITE(...)
#define LOG_ERROR(...)
#define LOG_WRITE_TRACE(...)
#define LOG_ERROR_TRACE(...)
#define LOG_WRITE_BUF(...)
#define LOG_FUNC_ENTER
#define LOG_FUNC_LEAVE
#define LOG_TRACE
#define ASSERT(const, ...)
#define ASSERT_RET(cont, ...)
#endif


#undef LOG_WRITE
#define LOG_WRITE(...)          Log::Write(TypeTrace_Info, __VA_ARGS__)


enum TypeTrace
{
    TypeTrace_Info,
    TypeTrace_Error
};

class Log
{
public:
    static void Trace(TypeTrace type, pchar module, pchar func, int numLine, char *format, ...);
    static void Write(TypeTrace type, pchar format, ...);
    static void DisconnectLoggerUSB();
    static void EnableLoggerUSB(bool enable);
    static int GetNumStrings();
};
