Sasha7b9Work/S8-57M/sources/Device/src/Display/Console.h

// (c) Aleksandr Shevchenko e-mail : Sasha7b9@tut.by
#pragma once


namespace Console
{
    void Init();

    void Draw();

    void AddString(pchar string);

    // Возвращает true, если консоль должна отображаться на экране
    bool IsShown();

    // Эту фнукцию надо вызвыть, когда пользователь изменяет максимальное количество строк в консоли
    void OnChanged_MaxStringsInConsole();
};
