Sasha7b9Work/S8-57M/sources/Panel/src/Hardware/Keyboard.h

// (c) Aleksandr Shevchenko e-mail : Sasha7b9@tut.by
#pragma once
#include "Controls.h"
#include "defines.h"


namespace Keyboard
{
    void Init();

    void Update();

    // Количество выводов RL для опроса клавиатуры
    const int NUM_RL = 6;

    // Количество выводов SL для опроса клавиатуры
    const int NUM_SL = 8;

    // Возращает имя органа управления
    pchar ControlName(Control control);
};
