Sasha7b9Work/S8-57M/sources/Device/src/Display/Grid.h

// (c) Aleksandr Shevchenko e-mail : Sasha7b9@tut.by
#pragma once


namespace Grid
{
    // Константы используются для расчёта размеров, которые остаются одинаковыми при любых размерах и пропорциях сетки - например, элементов меню
    const int WIDTH = 560;
    const int HEIGHT = 400;
    const int SIZE_CELL = 40;

    void Draw();

    // Эти значения могут меняться в зависимости от выставленного режима
    int Left();
    int Top();
    int Width();
    int Height();
    int Bottom();
    int Right();
    int ChannelCenterHeight();
    int ChannelHeight();
    int FullBottom();
    int MathBottom();
    int MathHeight();
    int ChannelBottom();
    // Возвращает нижнюю y-координату окна, в котором нужно выводить предупреждения
    int BottomForWarnings();
};
