Sasha7b9Work/S8-57M/sources/Device/src/Recorder/DisplayRecorder.h

// (c) Aleksandr Shevchenko e-mail : Sasha7b9@tut.by
#pragma once
#include "Osci/ParametersOsci.h"


struct Record;


namespace DisplayRecorder
{
    void Update(int field);

    // Сместить окно просмотра влево
    void MoveWindowLeft();

    // Сместить окно просмотра вправо
    void MoveWindowRight();

    // Переместить текущий курсор влево
    void MoveCursorLeft();

    // Переместить текущий курсор вправо
    void MoveCursorRight();

    // Возвращает true, если как раз происходит отображение данных
    bool InProcessUpdate();

    // Установить отображаемую запись
    void SetDisplayedRecord(Record *record, bool forListening);

    struct Cursor
    {
        enum E
        {
            _1,
            _2
        };
    };


    // Скорость перемещения окна по памяти в режиме просмотра
    struct SpeedWindow
    {
        enum E
        {
            Cell,           // 1 клетка
            _1Window,       // 1 окно
            _10Windows      // 10 окон
        } value;

        SpeedWindow(E v) : value(v)  { }

        int NumPoints() const;      // Возвращает число точек, на которое нужно сдвинуть экран
    };

    extern SpeedWindow speed;
};
