Sasha7b9Work/S8-57M/sources/Panel/src/Display/PainterText.cpp

// (c) Aleksandr Shevchenko e-mail : Sasha7b9@tut.by
#include "Painter.h"
#include "Display/Font/Font_p.h"
#include "Display/Text.h"
#include "Utils/Math.h"
#include <cstdarg>
#include <cstdio>
#include <cstring>



int Painter::DrawFormatText(int x, int y, char *format, ...)
{
    char buffer[200];
    std::va_list args;
    va_start(args, format); //-V2528
    std::vsprintf(buffer, format, args);
    va_end(args);
    return Text::Draw(x, y, buffer);
}


int Painter::DrawFormText(int x, int y, Color color, pString text, ...)
{
    color.SetAsCurrent();

#define SIZE_BUFFER_DRAW_FORM_TEXT 200
    char buffer[SIZE_BUFFER_DRAW_FORM_TEXT];
    std::va_list args;
    va_start(args, text); //-V2528
    std::vsprintf(buffer, const_cast<char *>(text), args);
    va_end(args);
    return Text::Draw(x, y, buffer);
}
