Sasha7b9Work/S8-57M/(commit log)

2020-12-15 Добавлены исхходники.
2022-04-20 компилируется DEvice vs-keil
2022-04-23 компилируется vs_keil
2022-11-28 CubeMX перешёл на 27ю1
2022-11-29 Добавлены схемы
    [УШЯИ.467444.128 Э3.sch, УШЯИ.468739.053 Э3-pcb.sch]
2022-11-29 Файлы возвращены к старой версии
2022-11-29 скрипты
2022-11-29 удалены предупреждения vs_keil
2022-11-29 Компилируется Keil Device
2022-11-29 Компилируется Keil с предупреждениями
2022-11-29 Компилируется Keil без предупреждений
2022-11-29 Keil компилируется после перехода на 479 и CubeMX 1.27.1
2022-11-29 Собирается keil с буфером под дисплей
2022-11-29 Дисплей подаёт признаки жизни
2022-11-30 Не работает с первой попытки
2022-11-30 Device не считает тики
2022-12-05 Не работает
2022-12-05 Ураааааааааааааааааааааа! !!! ЗАработало !!!!!!!!!!!!!!!!!!
2022-12-05 работает на релизе
2022-12-05 На release не всё отрисовывает
2022-12-05 Частично перерисовано изображение под новые реалии
2022-12-05 Нормально отрисовываются буквы
2022-12-05 Сетка отрисовывается
2022-12-05 Кнопки работают крайне неустойчиво
2022-12-05 Не работает заполнение произвольного прямоугольника
2022-12-05 Возврат к рабочей версии
2022-12-05 Release-версия Device работает
2022-12-05 Начинаем рефакторинг передачи координат, т.к. сейчас y может занимать 2 байта
2022-12-06 Рефакторинг отрисовки закончен
2022-12-06 Выделен буфер в ССM для отрисовки
2022-12-06 Подготовка к рисованию в заднем буфере
2022-12-06 Не работает отрисовка в заднем буфере, но что-то есть
2022-12-06 Работает на заливке прямоугольника
2022-12-06 SetPoint() работает
2022-12-06 Отрисовывает только нижнюю часть.
2022-12-06 Рисует весь экран
2022-12-06 Ускорена отрисовка путём отброса HiPart
2022-12-06 Ускорение DrawVLine закончилось ничем
2022-12-06 Нет, ускорение всё-таки есть
2022-12-06 DrawHLine точно ускорить не удалось
2022-12-06 Нет, удалось
2022-12-06 Опытным путём установлено, что отрисовка сигналов занимает много времени - каждый сигнал 10 и более мс - итого более 50 мс вместе с окном памяти
2022-12-06 Сетка отрисована полностью
2022-12-06 Кнопки присылают сигналы
2022-12-07 Работает панель. Происходит сброс после нажатия кнопок (видимо, после попытки сохранения Настроек)
2022-12-07 Появился сигнал
2022-12-13 DLoader компилируется с новым conf.h
2022-12-13 Не работает программа - прыгает из загрузчика, но зависает на обмене с дисплеем
2022-12-14 реализовано сохранение/загрузка настроек
2022-12-14 всё компилируется на vs_keil
2022-12-15 Постепенно переходим на выбор разрешения
2022-12-15 Осталось текст перевести на двойное разрешение
2022-12-15 Теперь дисплей может рисовать в двух разрешениях
2022-12-15 Наконец-то получен полный сигнал
2022-12-15 реализован алгоритм отрисовки сигнала на стороне панели
2022-12-15 Как ни странно, работает отрисовка сигнала
2022-12-15 Оптимизировано в части отрисовки MemoryWindow
2022-12-20 Начало двух режимов отрисовки
2022-12-21 Реализована команда переключения разрешения дисплея
2022-12-22 Отображение Choice исправлено
2022-12-22 Восстановлено отображение консоли
2022-12-22 Частично восстановлена сетка
2022-12-27 Скорректировано отображение курсора уровня синхронизации
2022-12-27 Скорректировано отображение малых кнопок
2022-12-27 Скорректировано отображение курсоров смещения по вертикали
2022-12-27 Диапазоны курсоров курсорных измерений
2022-12-27 Вместо временных курсоров рисует точки
2022-12-28 Не работает запись в консоль из панели
2022-12-28 Возможно, неправильно настроены пины
2022-12-28 Исправлена запись в device
    [HAL_FSMC_stm.cpp]
2022-12-28 Не компилируется. В процессе курсоров
2023-01-06 исправлены артефакты на изображении при переключении TBase
2023-01-09 точки рисуются
2023-01-09 количество цветов увеличено до 64
2023-01-10 Стало зависать
2023-01-10 исправлено зависание
2023-01-10 Нормальные цвета в поточечном режиме. Второй канал всё так же отсутствует
2023-01-10 Правильно рисуется первый канал точками
2023-01-10 частично преобразована отрисовка линии
2023-01-10 улучшена отрисовка точек
2023-01-10 Завршена отрисовка линиями
2023-01-10 Начинаем рефакторинг отрисовки элементов меню
2023-01-12 рефакторинг отрисовки меню закончен
2023-01-12 В состав репозитария внесён MatrixFont для генерации шрифтов
2023-01-12 Пробуем переходить на новый шрифт
2023-01-12 готовимся к переходу на новые шрифты
2023-01-12 Шрифты русуются
2023-01-13 шрифт ГОСТ В (утолщённый)
2023-01-23 Четырёхсимвольные значки стали неправильно показываться
2023-01-23 Четырёхсимвольные значки всё так же неправильно отображаются
2023-01-24 Добавлены некоторые УГО автоматических измерений
2023-01-24 Завершены УГО изображений
2023-01-24 Добавлены старые шрифты
2023-01-26 Теперь точек не может быть меньше 1024Э
2023-01-26 Исправлен спектр
2023-01-26 КУрсорные измерения
2023-01-30 Работает отрисовка обоих каналов
2023-01-30 Удалено логгирование
2023-01-30 пиковый детектор неправильно рисует
2023-01-30 Поточечный режим пикового детектора работает правильно
2023-01-30 Пиковый детектор рисует линиями почти правильно
2023-01-31 Смещение по вертикали правильно работает
2023-01-31 Смещение по вертикали правильно работае
2023-01-31 Переделываем функции, рисующие до меню
2023-01-31 переделана дополнительная функция отрисовки
2023-02-01 Установка времени работает
2023-02-01 Стрелки на странице ПАМЯТЬ-ПОСЛЕДНИЕ
2023-02-01 Информация о текущем курсоре на странице курсоров спектра
2023-02-01 Страница Внутр ЗУ работает
2023-02-01 Частотомер закончен
2023-02-02 Теперь меню всегда на весь экран можно сделать
2023-02-02 Удалена разница для страницы, динамически изменяемой. Похоже, разницы со статической нет никакой
2023-02-02 Пытаемся обновить библиотеку USBD, чтоб заработало
2023-02-02 библиотеки usbd, usbh обновлены
2023-02-02 Закомментирован PCD_HandleTypeDef hpcd;
2023-02-06 Заменены файлы USBH
2023-02-07 Пробую переводить loader на 6-ю версию компилятора
2023-02-07 Не работает загрузчик на 6-й версии компилятора - не переходит по нужному адресу
2023-02-07 Возврат loader на версию 5 компилятора
2023-02-07 Работает loader на 6-й версии комплиятора
2023-02-07 Отмена замены USBH, потому что так не работал
2023-02-07 Предварительный перевод Panel на 6-й компилятор
2023-02-07 Panel на 6-й версии компилятора
2023-02-07 Device на 6-й версии компилятора не запускается
2023-02-07 Не работает Device
2023-02-07 Возврат на 5-ю версию компилятора, где компилировалось Device
2023-02-08 Флешку определяет
2023-02-08 Сохранение на флешку работает, но почему-то звук идёт
2023-02-08 Сохраняет на флешку, но очень долго - 10 секунд
2023-02-09 Символ автоизмерения
2023-02-09 Кнопка ВНИЗ работает ценой чудовищного хака
2023-02-14 Выровнены надписи на странице выбора автоматических измерений
2023-02-21 растянут рандомизатор
2023-02-27 на 50 нс, кажется, нормально рандомизатор стрОит
2023-02-27 Исправлен вывод в рандомизаторе
    [Osci.cpp]
2023-03-02 Вроде пиковый детектор заработал
2023-03-03 Исправил чтение пикового детектора в поточечном режиме, но всё равно рисует неправильно
    [Roller.cpp]
2023-03-07 wxWidgets версии 3.2.2.1
2023-03-07 не компилируется vs_win
2023-03-09 Дёргание по горизонтали сигнала в поточечном режиме ликвидировано
2023-03-09 Вроде бы пиковый детектор в поточечном режиме нормально показывает
2023-03-09 нормально выводит в поточечном пиковый детектор
2023-03-09 Теперь поточечный режим от 50 ms
2023-03-14 Теперь поточечная развёртка корректно отрисовывается при переключении TBase туда-сюда
2023-03-14 Отключён значок пикового детектора
2023-03-21 кажется работает баланс
2023-03-21 подправлен вывод текста в окошке
2023-03-21 Не работает калибровка
2023-03-21 работает балансировка каналов
2023-04-05 Задержка выключения убрана
2023-04-12 Подправил зависание в обмене с панелью
2023-04-12 Поставил таймоуты на других местах в обмене с панелью.
